Antonia-Tunsoiu/4-Stage-Amplifier/PROIECT LA DISCIPLINA SCIA.pdf

# PROIECT LA DISCIPLINA SCIA

# SEMESTRUL I

2025-2026

### Student: Tunsoiu Antonia-Emilia

### Anul III, grupa 2132, Specializarea electronică aplicată

## 1.Tematica proiectului

Să se proiecteze un circuit format din 4 etaje care să respecte următoarele specificații:

Etaj 1
Tip Sursă semnal | Amplitudine minimă | Amplitudine maximă | Unitate măsură | Tip Etaj 1 | Câștig etaj 1 (liniar)
2 | 1.40E-01 | 2.79E-01 | V (diferențial) | 4 | 5

Etaj 2
Tip Etaj 2 | Câștig în banda de trecere (liniar) | Rintrare minim | Bandă | Q
1 | 1 | 7.50E+02 | 8.00E+03 | 1.41

Etaj 3
Tip Etaj 3 | Câștig minim [db] | Rezoluție [db] | Nr. pași | Câștig maxim | Rintrare minim
1 | 8 | 2 | 4 | 14 | 1.50E+03
Etaj 4 | Tip AO
Tip etaj 4 | Câștig etaj 4 (liniar) | ADA4077
10 | 1

## 2.Implementare teoretică

## 1. ETAJ 1

### 1.1. Specificații

Etaj 1
Tip Sursă semnal | Amplitudine minimă | Amplitudine maximă | Unitate măsură | Tip Etaj 1 | Câștig etaj 1 (liniar)
2 | 1.40E-01 | 2.79E-01 | V (diferențial) | 4 | 5

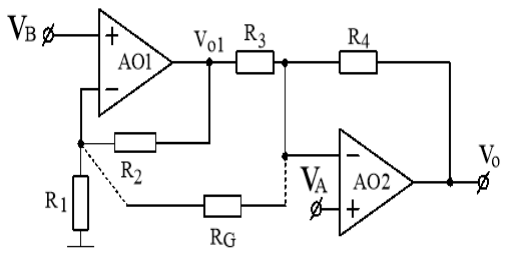
[picture p1: figure]
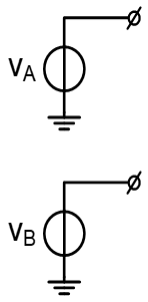
[picture p2: figure]

Fig.1. Tip 2 Sursă Semnal | Fig. 2. Tip 4 Etaj 1

Primul etaj constă într-un amplificator de instrumentație realizat într-o configurație cu două amplificatoare operaționale de precizie ADA4077. Circuitul beneficiază de o alimentare simetrică de ±5V, asigurând o procesare stabilă a semnalului de intrare diferențial, a cărui amplitudine variază între 140 mV și 279 mV, iar etajul asigură un câștig liniar de 5.

### 1.2. Dimensionarea și proiectarea Etajului 1

### 1.2.1. Proiectarea sursei de tensiune

Pentru simularea alimentării diferențiale s-au utilizat două surse de tensiune comandate în tensiune (E1 și E2). Sursa de intrare Vid stabilește amplitudinea diferențială totală, între 140 mV – 279 mV. Cele două surse comandate au factori de transfer de 0.5 și astfel generează semnale în antifază raportate la nodul comun. Sursa Vicm permite setarea tensiunii de mod comun. Este setată la 0, pentru a asigura o ieșire simetrică față de masă.

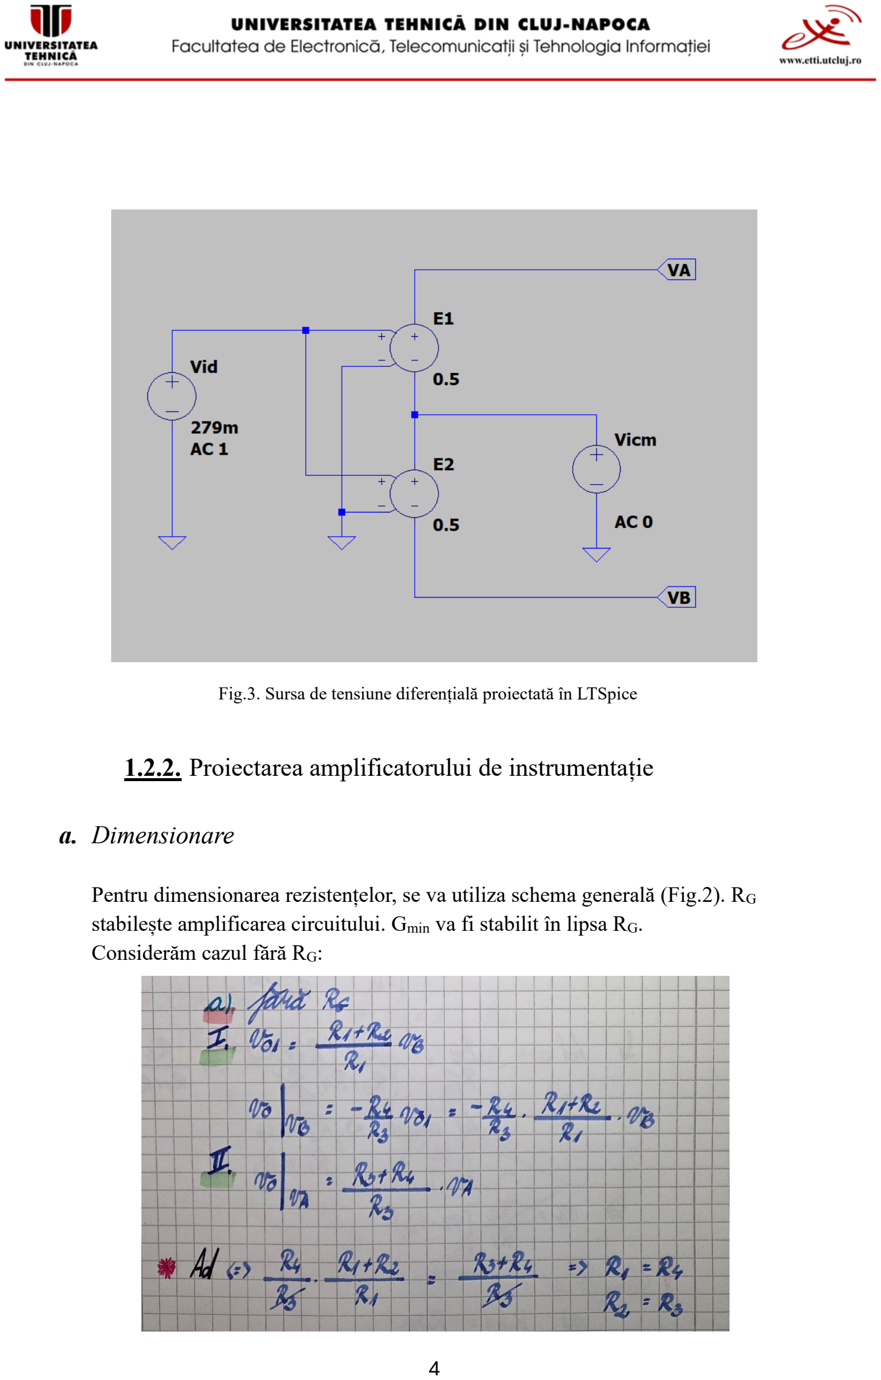
[picture p3: page 4]

Fig.3. Sursa de tensiune diferențială proiectată în LTSpice

### 1.2.2. Proiectarea amplificatorului de instrumentație

### a. Dimensionare

Pentru dimensionarea rezistențelor, se va utiliza schema generală (Fig.2). RG stabilește amplificarea circuitului. Gmin va fi stabilit în lipsa RG.
Considerăm cazul fără RG:

Pentru a respecta condițiile unui amplificator de instrumentație, se impun condițiile: R1 = R4
R2 = R3
Simplificând relația, rezultă amplificarea pentru Gmin:
Vout = (1 +

R3
R4
) (VA − VB) | unde | VA − VB= Vid

Alegem Gmin=2.5 și dimensionăm R1, R2, R3, R4.
- Rezistențele de valori mici vor permite trecerea unui curent de valori mari, ceea ce va distruge circuitul.
- Rezistențele de valori mari pot degrada marja de fază a circuitului și pot introduce zgomot suplimentar în circuit.
Alegem:
R1 = R4 = 1.5 kΩ
R2 = R3 = 1 kΩ

Aceste valori sunt suficient de mari cât să limiteze curentul, dar puterea disipată pe ele este destul de mică astfel încât rezistențele nu se vor încinge deloc

Considerăm cazul cu RG:

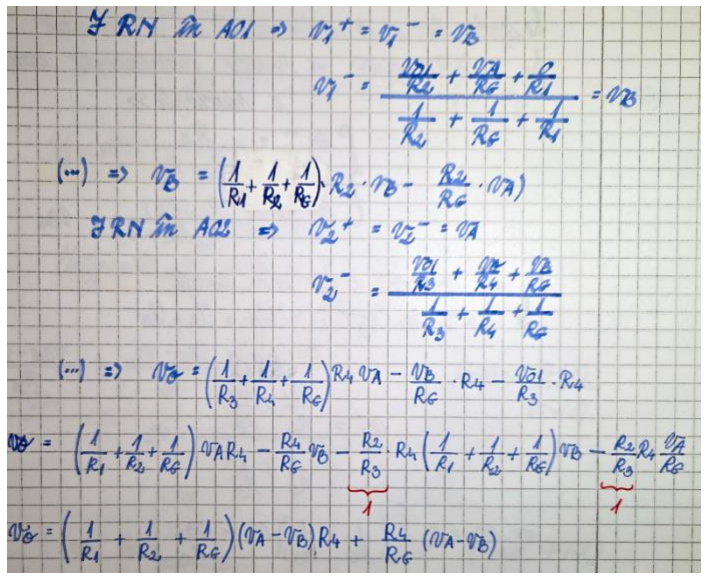
[picture p4: figure]

Din calcul, rezultă amplificarea pentru G:

Vout = (1 +

R3
R4

+

2 ∗ R4
RG

) (VA − VB)

Alegem RG=1.2k. Pentru a respecta valorile standardizate și pentru a păstra precizia, vom conecta în serie 3 rezistențe:

RG1 = 1 kΩ | ; | RG2 = RG3 = 100Ω

### b. Proiectare

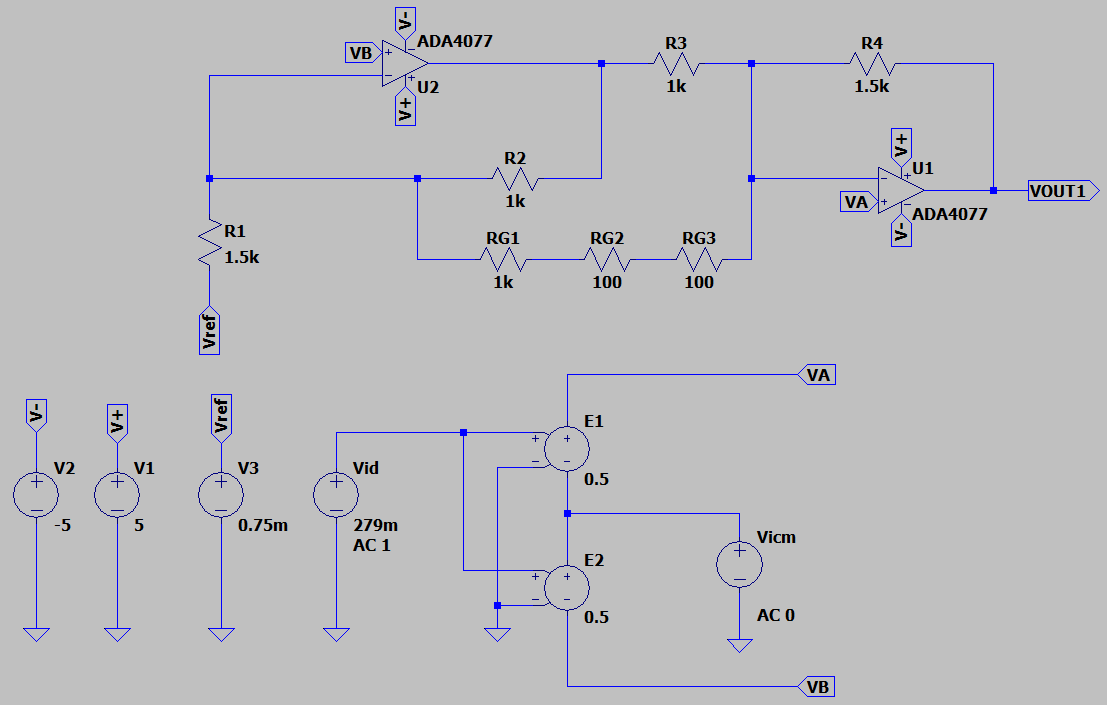
[picture p5: figure]

Fig.4. Proiectarea generatorului de semnal și a Etajului 1

### 1.3. Caracterizarea Etajului 1

a) DC OP

### - Punctul static de funcționare

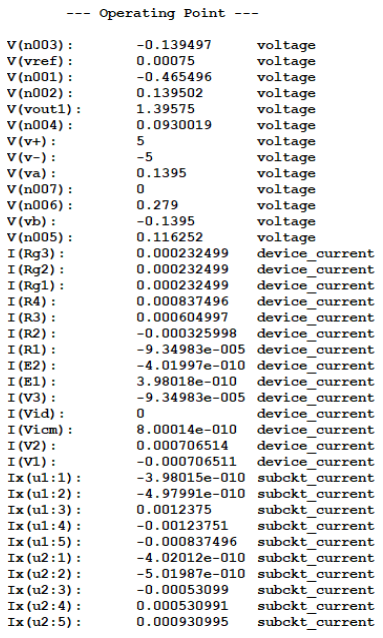
[picture p6: figure]

1. Tensiunea de Ieșire

V(vout1) = 1.39575V.
Valoarea se află în intervalul dat de tensiunea de alimentare pozitivă (+5V) și cea negativă (-5V), deci semnalul de ieșire nu va fi limitat.
2. Câștigul liniar

1.395V / 0.279V = 5.

3. Curenții de intrare

Curenții Ix(u1:1) și Ix(u2:1) sunt de ordinul picoAmperilor, ceea ce evidențiază impedanța de intrare foarte mare a etajului.

Fig.5. Analiza .op pentru amplitduinea maxima de intrare

1. Tensiunea de Ieșire

V(vout1) = 0.700748V.
Valoarea se află în intervalul dat de tensiunea de alimentare pozitivă (+5V) și cea negativă (-5V), deci semnalul de ieșire nu va fi limitat.
2. Câștigul liniar

0.700V / 0.140V = 5.

3. Curenții de intrare

Curenții Ix(u1:1) și Ix(u2:1) sunt de ordinul picoAmperilor, ceea ce evidențiază impedanța de intrare foarte mare a etajului.

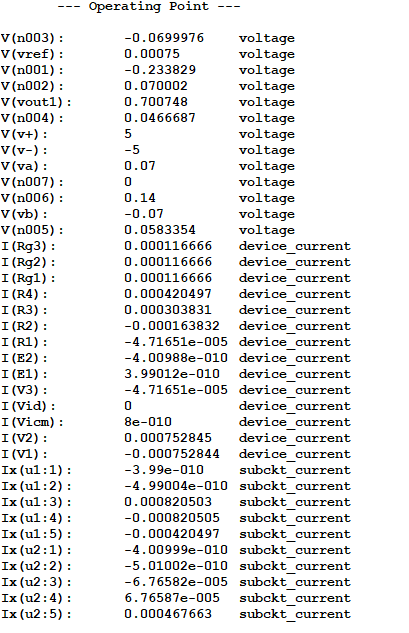
[picture p7: figure]

Fig.6. Analiza .op pentru amplitduinea minima de intrare

### - Compensarea nivelului DC la ieșire

S-a realizat cu ajutorul unei surse de tensiune constantă, aplicată la capătul rezistenței R1. Pentru a stabili valoarea sursei, sursa de semnal de intrare a fost setată la 0V și s-a analizat deplasarea axei în raport cu 0, prin analiza .op.

Pentru a respecta amplificarea de 5 atât pentru amplitudinea minimă, cât și cea maximă, s-a ales ca tensiunea de referință să aibă valoarea de 0.75 mV:

Amplitudine semnal
intrare

Tensiune de ieșire
FĂRĂ Vref

Tensiune de ieșire
CU Vref

Tensiune de ieșire
ideală
140 mV | 699.99796 mV | 700.74797 mV | 700 mV
279 mV | 1.3949959 V | 1.3957459 V | 1.395V

b) AC
Pentru analiza în frecvență, am setat o simulare AC cu următorii parametri:

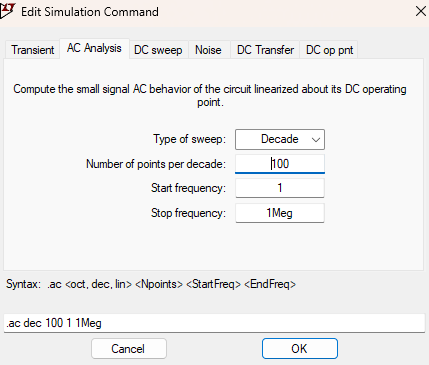
[picture p8: figure]

Fig.7. Setarea analizei AC

### - Câștig la joasă frecvență

Matematic, câștigul la joasă frecvență este dat de formula 20 lg(|G|). Astfel, câștigul la joasă frecvență pentru circuitul dat este: 13.97 dB. Acest rezultat este verificat și de graficul tensiunii de ieșire:

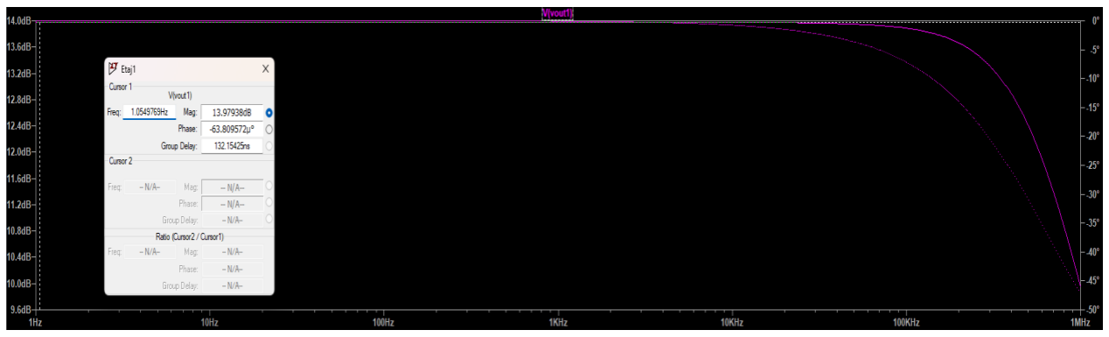
[picture p9: figure]

Fig.8. Verificarea câștigului la joasă frecvență

### - Banda etajului > Banda filtrului (etaj 2)

În specificațiile proiectului, banda filtrului din etajul 2 este de 8 kHz. Banda etajului 1 este dată de valoarea frecvenței la -3dB, raportat la câștigul la joasă frecvență. Așadar, trebuie să determinăm frecvența la 10.97 dB:

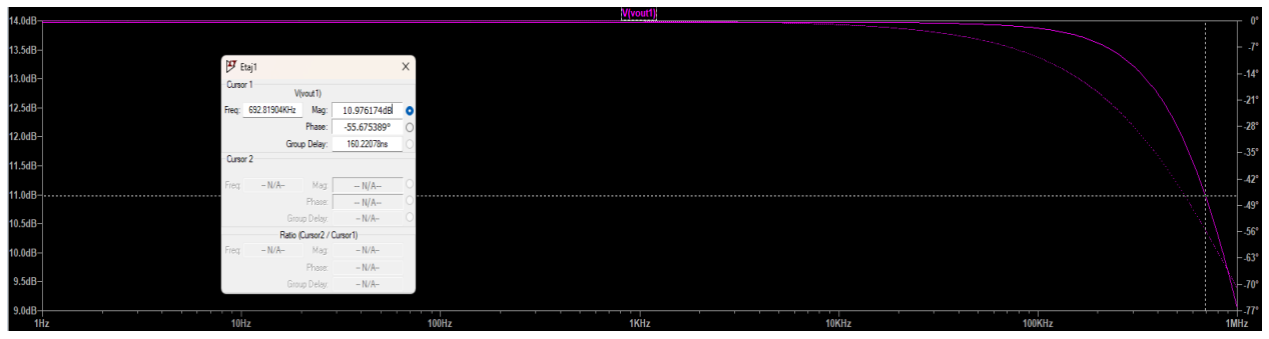
[picture p10: figure]

Fig.8. Determinarea benzii

Din această simulare se observă că frecvența de tăiere este 692.81904kHz.

692.81904kHz > 8 kHz, deci primul etaj nu va introduce atenuări sau defazaje ce ar putea influența performanța celui de-al doilea etaj.

Conform fișei tehnice, ADA4077 are un GBW de 3.9 MHz. Frecvența maximă a circuitului se calculează cu formula: fmax =

GBW
G

=

3.9 MHz
5

= 780 kHz.

692.8 kHz < 780 kHz, deci circuitul se încadrează în limitele fizice ale componentei, oferind în același timp o bandă suficientă pentru a nu influența etajele următoare.

### - CMRR

CMRR reprezintă capacitatea unui amplificator de a respinge semnalele nedorite. Este raportul dintre câștigul în mod diferențial (Ad) și câștigul în mod comun (Acm).

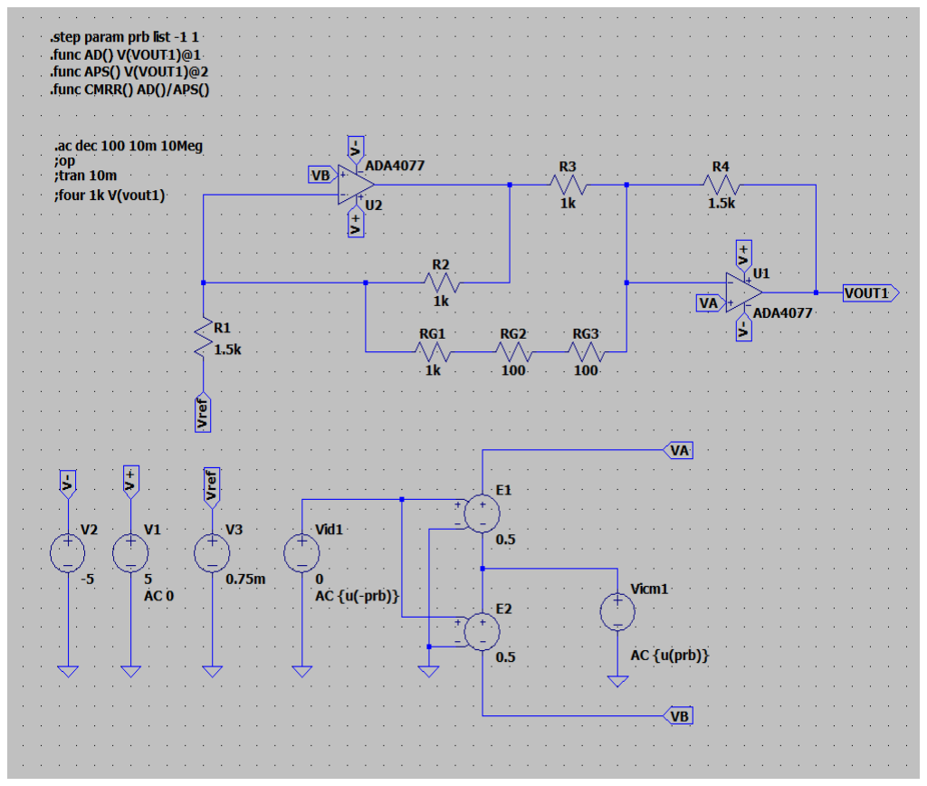
[picture p11: figure]

Pentru a vizualiza
graficul CMRR s-a utilizat analiza parametrică. Inițial, intrarea Vid1 a fost activată,
permițând | măsurarea
câștigului diferențial.

În etapa a doua,
semnalul de mod comun a
fost injectat simultan pe
ambele intrări ale etajului, facilitând determinarea
câștigului de mod comun.

Fig.9. Definirea analizei
parametrice pentru CMRR

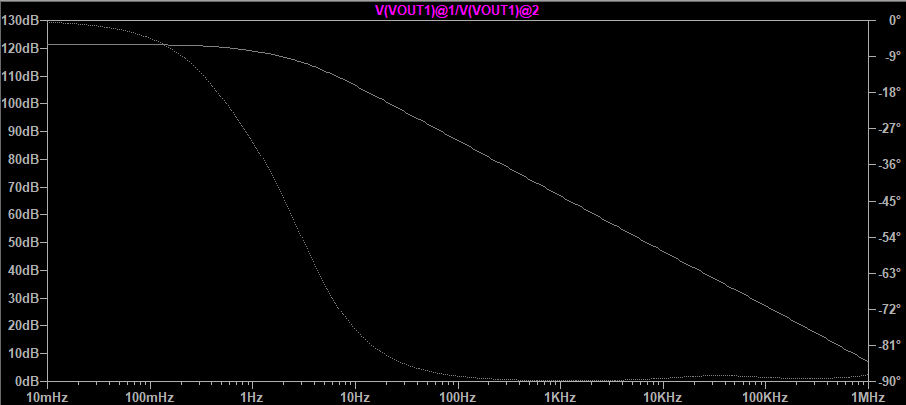
[picture p12: figure]

Fig.10. Graficul raportului CMRR

Fișa de catalog a ADA4077 indică o valoare a CMRR între 122dB – 140dB. În simularea realizată, valoarea CMRR atinge pragul de 122dB în punctul său maxim. Astfel, rezultatele demonstrează precizia deosebită a amplificatorului în eliminarea erorii cauzate de tensiunea de mod comun. Deși rejecția scade odată cu creșterea frecvenței, amplificatorul menține o valoare ridicată, garantând astfel integritatea semnalului.

### - PSRR

PSRR reprezintă capacitatea unui circuit electronic de a menține neschimbată tensiunea de ieșire atunci când apar perturbații. Este raportul dintre câștigul în mod diferențial (Ad) și câștigul parazit al alimentării (Aps).

Pentru | a | vizualiza
graficul PSRR s-a utilizat analiza parametrică. Inițial, intrarea Vid1 a fost activată,
permițând | măsurarea
câștigului diferențial.

În etapa a doua, un
semnal perturbator de tip AC a fost injectat simultan pe ambele ramuri de alimentare.
Această | configurație | a
facilitat | determinarea
câștigului parazit indus de variațiile alimentării.

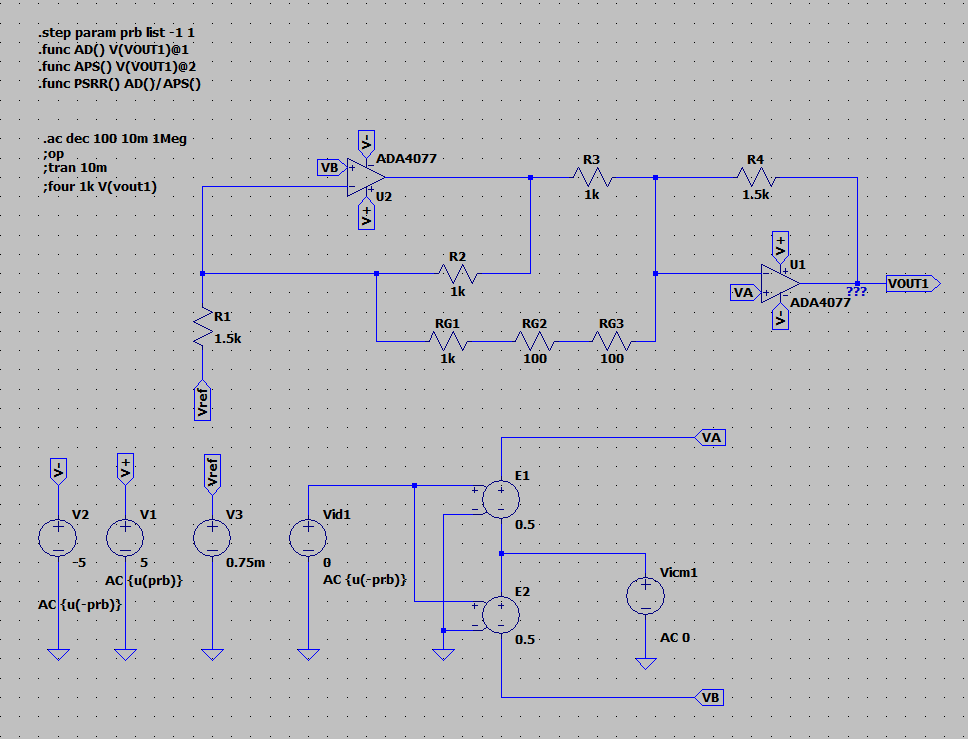
[picture p13: figure]

Fig.11. Definirea analizei parametrice pentru PSRR

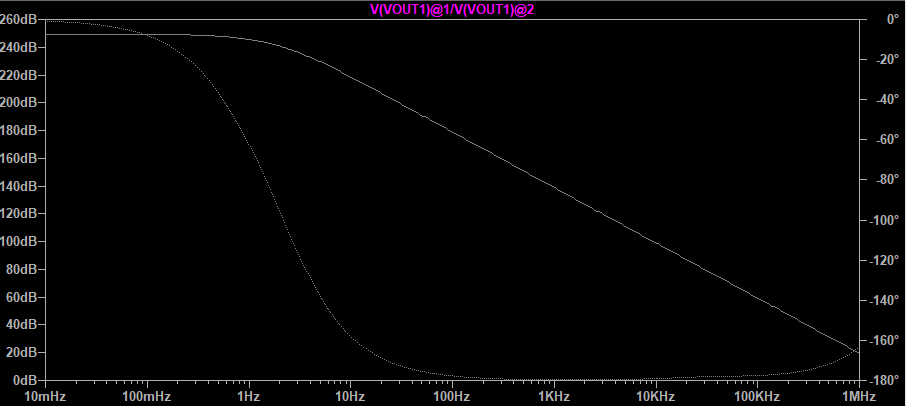
[picture p14: figure]

Fig.10. Graficul raportului PSRR

Fișa de catalog a ADA4077 specifică o valoare a PSRR între 123 dB – 128 dB. În simularea realizată, valoarea PSRR depășește pragul de 120dB, atingând un maxim ideal de aproximativ 250dB la frecvențe sub 1Hz. Astfel, rezultatele demonstrează precizia deosebită a amplificatorului în eliminarea erorilor cauzate de variațiile tensiunii de alimentare. Deși rejecția scade odată cu creșterea frecvenței, amplificatorul menține o valoare ridicată a acesteia, garantând astfel integritatea semnalului și stabilitatea punctului de funcționare. Această performanță superioară asigură menținerea distorsiunilor sub pragul de 1%, eliminând riscul ca zgomotul de alimentare să moduleze semnalul util de ieșire.

c) TRANSIENT

### - Slew Rate

Slew Rate-ul reprezintă viteza maximă cu care tensiunea de ieșire a unui amplificator poate varia în timp. Pentru determinarea Slew Rate-ului, s-a aplicat la intrare un semnal de tip impuls cu amplitudine mare, pentru a scoate amplificatorul din regimul liniar de semnal mic.

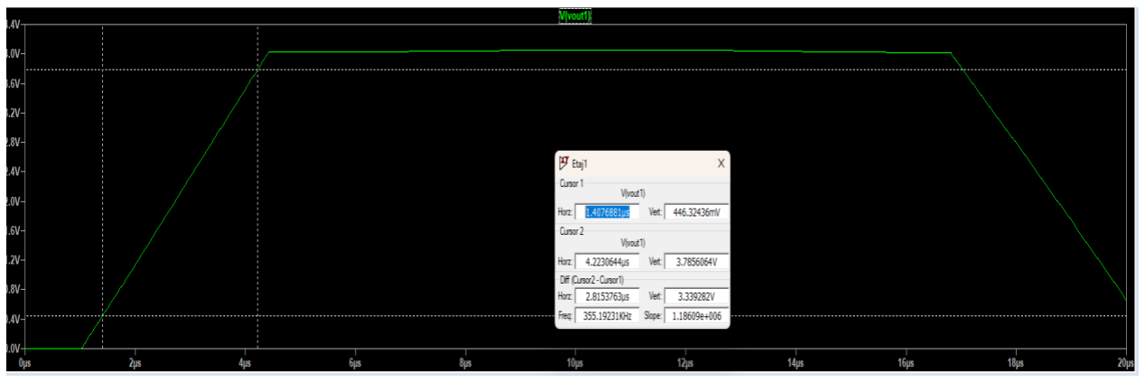
[picture p15: figure]

Fig.9. Determinarea SR

Conform graficului din Fig.9. și a formulei de calcul, SR circuitului este:

SR =

ΔVOUT
Δt

= 1.186 V/us

Conform fișei tehnice, ADA4077 are un Slew Rate de 1.2 V/µs. Acest lucru confirmă că primul etaj poate urmări rapid semnalele de intrare fără a introduce distorsiuni de pantă în banda de lucru.

Se calculează SR pentru semnalul rezultat în Fig.9: SR = 2πfVOUT = 0.201 V/us. Așadar, SR rezultat din măsurătorile din LTSpice este cu mult mai mare decât SR necesar, conform calculelor.

### - Total Harmonic Distortion

Total Harmonic Distortion (THD) este un parametru ce evaluează fidelitatea unui circuit prin măsurarea gradului de "poluare" a semnalului original cu componente spectrale nedorite (armonici). Ideal, acesta este 0, așadar în practică se dorește a fi cât mai mic ( THD < 1%).

Pentru a verifica performanța etajului în cel mai defavorabil scenariu, s-a aplicat la intrare un semnal sinusoidal cu amplitudinea maximă de 279 mV. În LTSpice, vom vizualiza o analiză de tip FFT:

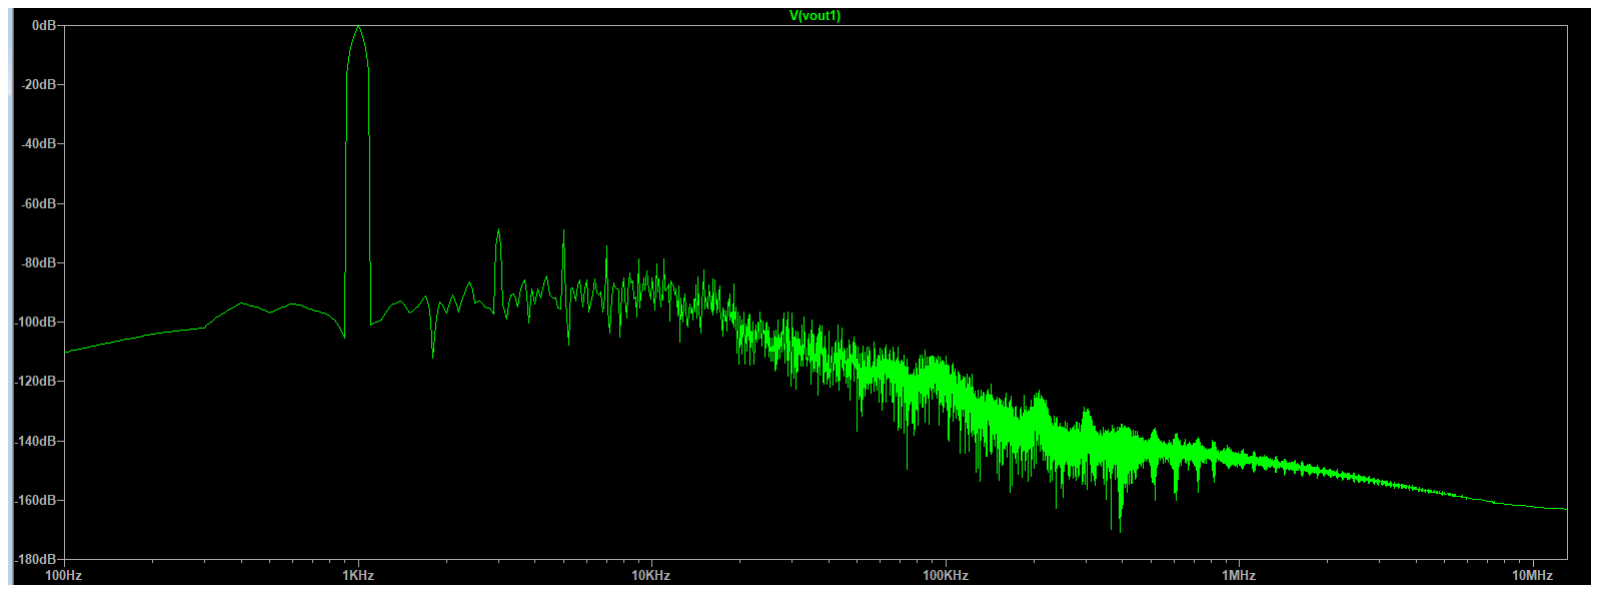
[picture p16: figure]

Fig.10. Analiza FFT

În grafic se observă un vârf proeminent la frecvența fundamentală (armonica 1), situat la aproximativ 0 dB. Armonicile de ordin superior au magnitudinea extrem de redusă, situându-se sub pragul de -70 dB față de fundamentală. Acest raport semnal-distorsiune foarte mare demonstrează că amplificatorul ADA4077 funcționează într-un regim de înaltă liniaritate.

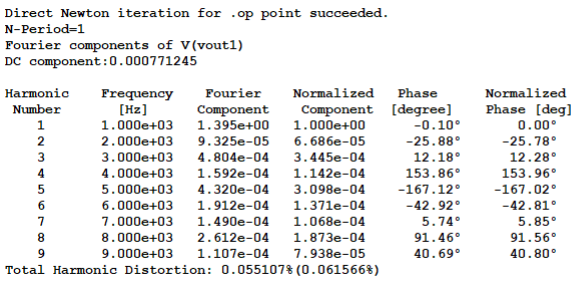
[picture p17: figure]

. | Fig.11. Error Log FFT

Observând rezultatele numerice din Error Log, pentru amplitudinea maximă, THD pentru worst case este 0.055% < 1%. Nivelul redus al distorsiunilor este susținut de rapoartele de rejecție ridicate, care împiedică zgomotul de mod comun sau cel de alimentare să moduleze semnalul util și să introducă componente armonice parazite.

## 2. ETAJ 2

### 2.1. Specificații

Etaj 2
tip Etaj 2 | |H0| câștig liniar în banda de trecere | R intrare minim | Banda | Q
1 | 1 | 7.50E+02 | 8.00E+03 | 1.41

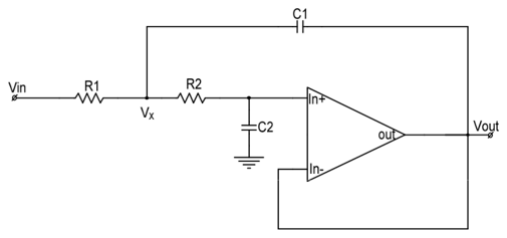
[picture p18: figure]

Fig.12. Tip 1 Etaj 2 – Filtru Low Pass Sallen Key

Al doilea etaj constă într-un filtru trece-jos realizat în configurație Sallen-Key de ordinul 2. Circuitul este un repetor, astfel că avem un câștig liniar unitar, asigurând integritatea amplitudinii semnalului în banda de trecere. Etajul este calibrat pentru o frecvență de tăiere de 8 kHz și un factor de calitate Q = 1.41, valoare specifică pentru o atenuare maximă în banda de trecere. Circuitul impune o rezistență de intrare minimă de 750Ω.

### 2.2. Dimensionarea și proiectarea Etajului 2

### 2.2.1. Proiectarea filtrului trece-jos

### a. Dimensionare

Pentru dimensionare se utilizează schema generală (Fig.12). Ca strategie de dimensionare, se obișnuiește să se aleagă R1 = R2:

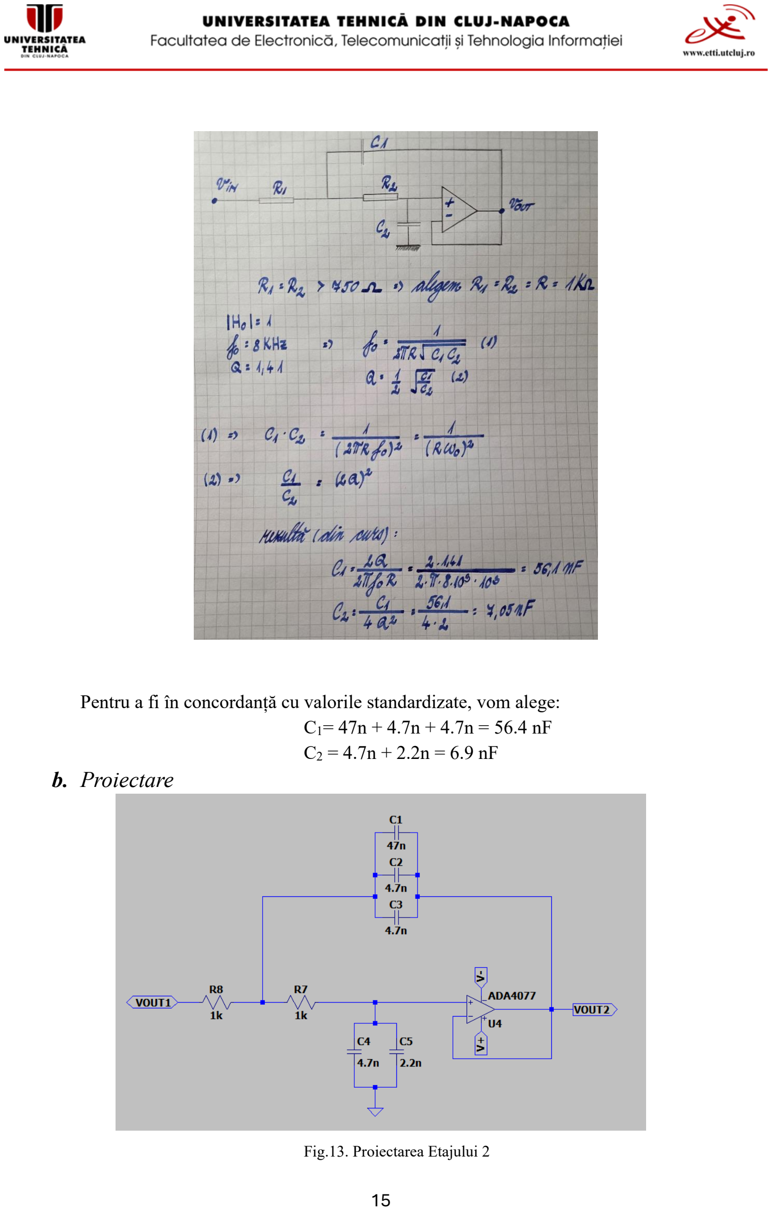
[picture p19: page 15]

Pentru a fi în concordanță cu valorile standardizate, vom alege: C1= 47n + 4.7n + 4.7n = 56.4 nF C2 = 4.7n + 2.2n = 6.9 nF

### b. Proiectare

Fig.13. Proiectarea Etajului 2

### 2.3. Caracterizarea Etajului 2

a) DC OP

### - Punctul static de funcționare

Pentru a demonstra că filtrul Sallen-Key realizat nu introduce niciun fel de eroare, am realizat o analiză de tip .op, cu tensiunea de intrare 0:

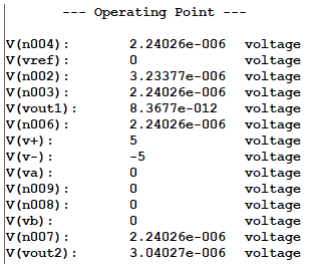
[picture p20: figure]

Fig.14. Analiza .op pentru tensiunea de intrare 0

Se observă că V(Vou2) este aproximativ 3uV, o valoare infimă care se poate neglija.

b) AC
Pentru analiza în frecvență, am păstrat parametrii analizei AC folosite în cadrul simulării etajului 1.

### - Câștigul în banda de trecere

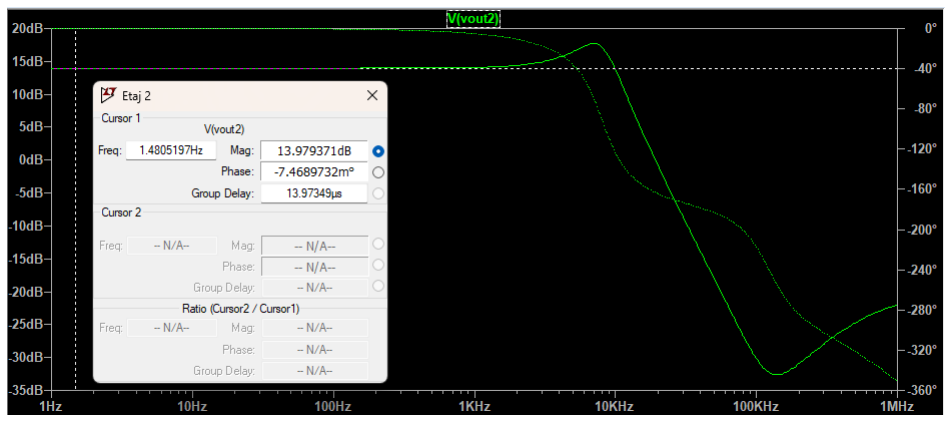
[picture p21: figure]

Fig.15. Câștigul în banda de trecere a filtrului

Fiind un filtru trece-jos în configurație de repetor, câștigul în decibeli, la ieșirea etajului, coincide cu câștigul de la intrarea acestuia (Fig.8). Peak-ul observat în jurul frecvenței de 8 kHz se datorează factorului de calitate, Q = 1.41 >0.707 => se observă o supracreștere în caracteristica de magnitudine ce favorizează o trecere mai bruscă de la banda de trecere la banda de tăiere în detrimentul liniarității.

### - Banda filtrului

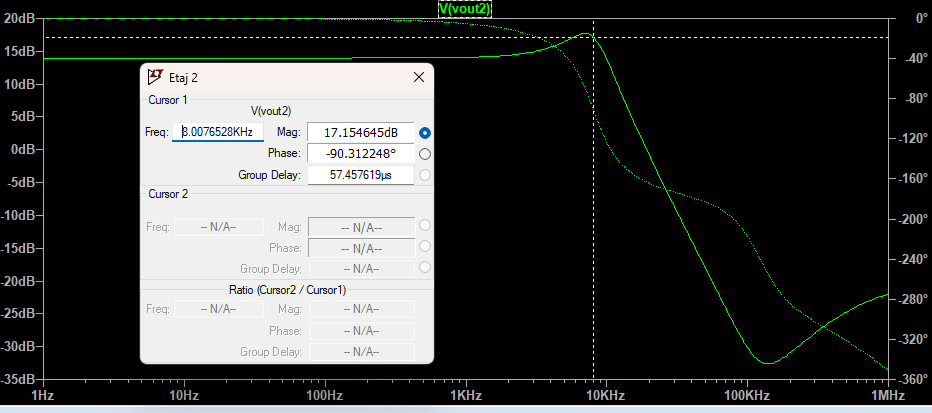
[picture p22: figure]

Fig.16. Calculul benzii filtrului

Un pol introduce un defazaj de -90 grade. Așa cum reiese din grafic, banda filtrului este de 8 kHz.

c) Transient

Pentru analiza de tip Transient, trebuie verificat faptul că nu există distorsiuni la frecvența fin/10. Amplitudinea de 279 mV ar trebui să genereze o tensiune de 1.395V la ieșire, valoare verificată în simulări prin graficul dat mai jos:

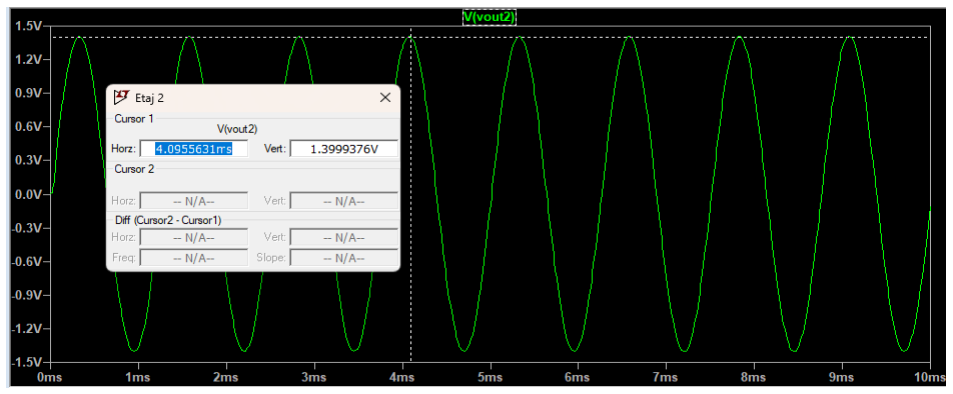
[picture p23: figure]

Fig.17. Analiza Transient pentru amplitudinea de intrare maximă

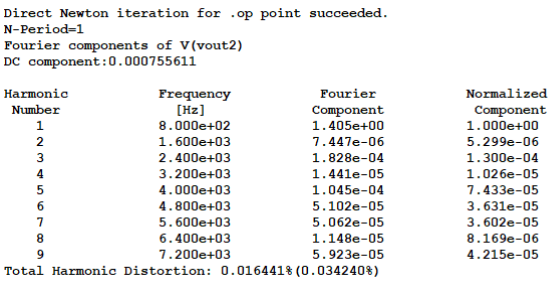
[picture p24: figure]

Fig.18. Valoarea THD la ieșirea etajului 2

La frecvența de 800 Hz, THD-ul total va fi 0.0164%, deci Etajul 2 funcționează optim ca repetor de tensiune în banda de trecere.

## 3. ETAJ 3

### 3.1. Specificații

Etaj 3

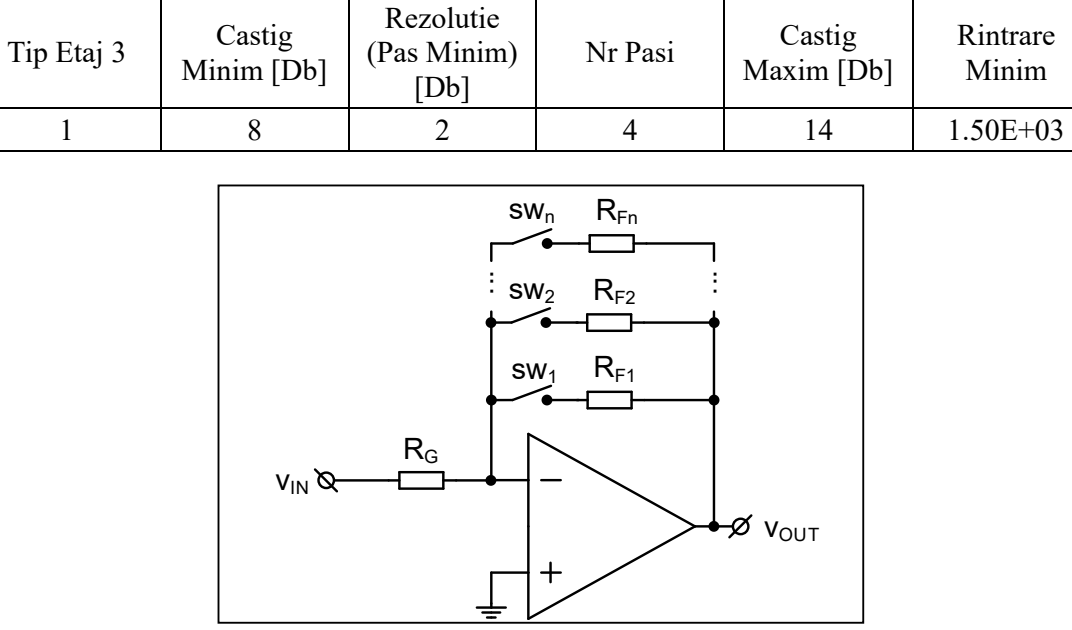
[picture p25: figure]
Tip Etaj 3; Castig Minim [Db]; Rezolutie (Pas Minim) [Db]; Nr Pasi; Castig Maxim [Db]; Rintrare Minim; vOUT; vIN; swn; RFn

Fig.19. Tip 1 Etaj 3

Etajul 3 este un amplificator inversor cu câștig programabil, configurat pentru a oferi un control al amplitudinii în 4 pași. Acesta asigură un câștig minim de 8 dB și un câștig maxim de 14 dB, având o rezoluție de 2 dB. Circuitul este proiectat cu o impedanță de intrare de minim 1.50 kΩ, utilizând o rețea de reacție cu switch-uri în calea de semnal.

### 3.2. Dimensionarea și proiectarea Etajului 3

### 3.2.1. Proiectarea amplificatorului de instrumentație

### a. Dimensionare

Pentru dimensionarea rezistențelor, se va utiliza schema generală (Fig.19).

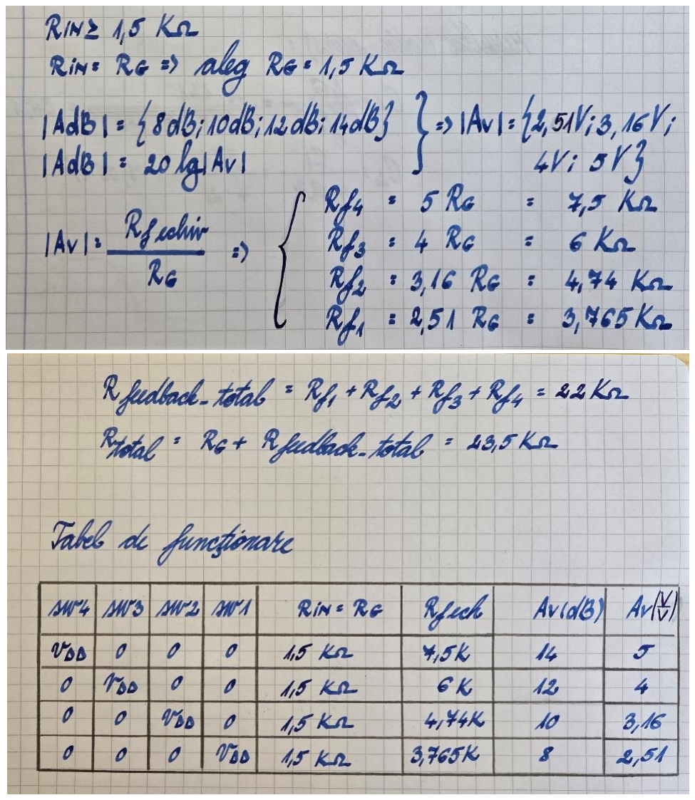
[picture p26: figure]

Fig.19 și 20. Proiectarea etajului 3 și tabelul de funcționare al PGA-ului

### b. Proiectare

Deoarece câștigul minim PGA pentru amplitudine maximă/ câștigul maxim PGA pentru amplitudine minimă va fi de 3.5 V, se va alege ca sursă de alimentare pentru etajul 3 valoarea de 10V (pentru a nu satura amplificatorul). Considerând calculele teoretice, s-au ales următoarele valori ale rezistențelor, în conformitate cu valorile standardizate:

Rezistența | Valoare calculată (Ω) | Valoare aleasă (Ω)
RG | 1.5 K | 1.5 K
Rf1 | 3.765 K | 3.770 K
Rf2 | 4.74 K | 4.474 K
Rf3 | 6 K | 6 K
Rf4 | 7.5 K | 7.5 K

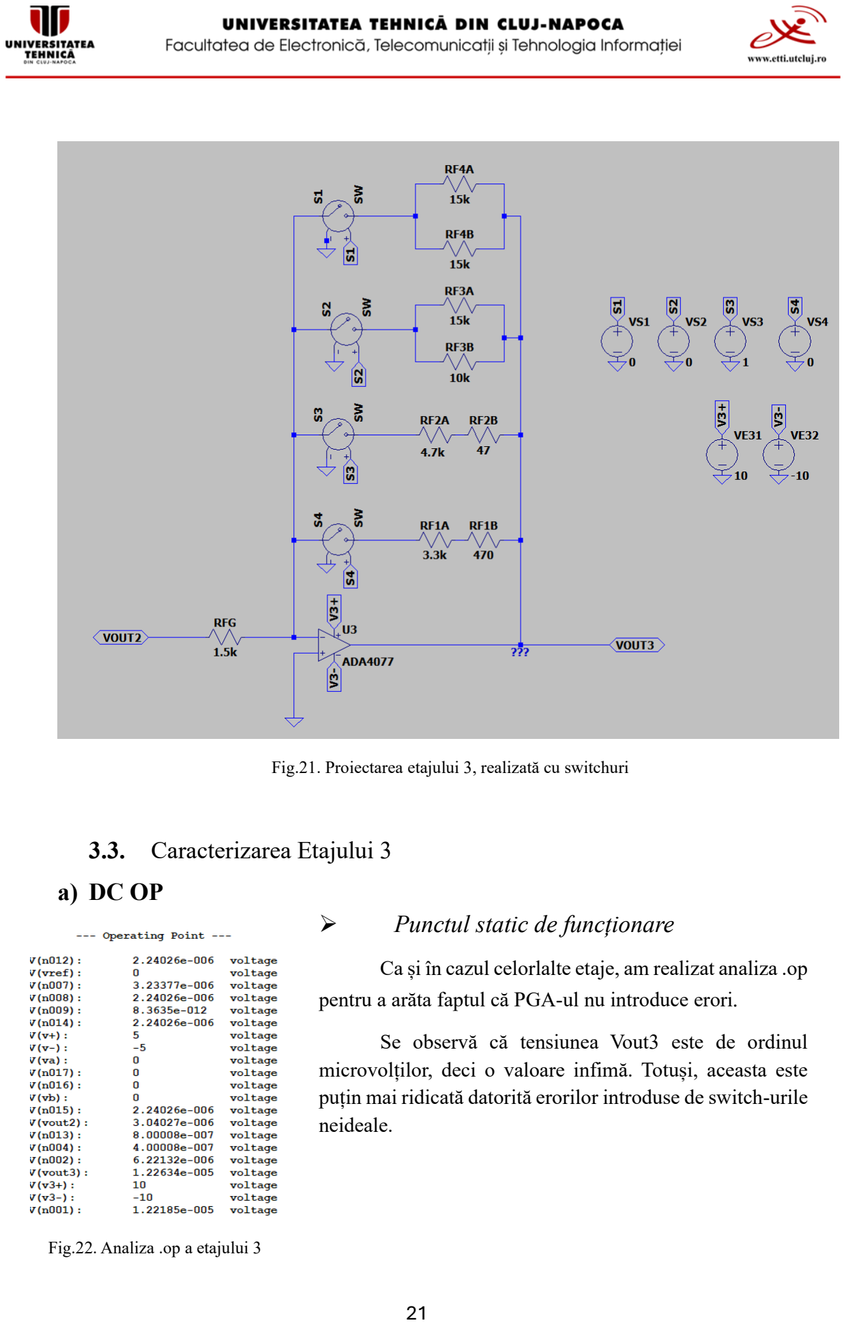
[picture p27: page 21]

Fig.21. Proiectarea etajului 3, realizată cu switchuri

### 3.3. Caracterizarea Etajului 3

a) DC OP

### - Punctul static de funcționare

Ca și în cazul celorlalte etaje, am realizat analiza .op pentru a arăta faptul că PGA-ul nu introduce erori.

Se observă că tensiunea Vout3 este de ordinul microvolților, deci o valoare infimă. Totuși, aceasta este puțin mai ridicată datorită erorilor introduse de switch-urile neideale.

Fig.22. Analiza .op a etajului 3

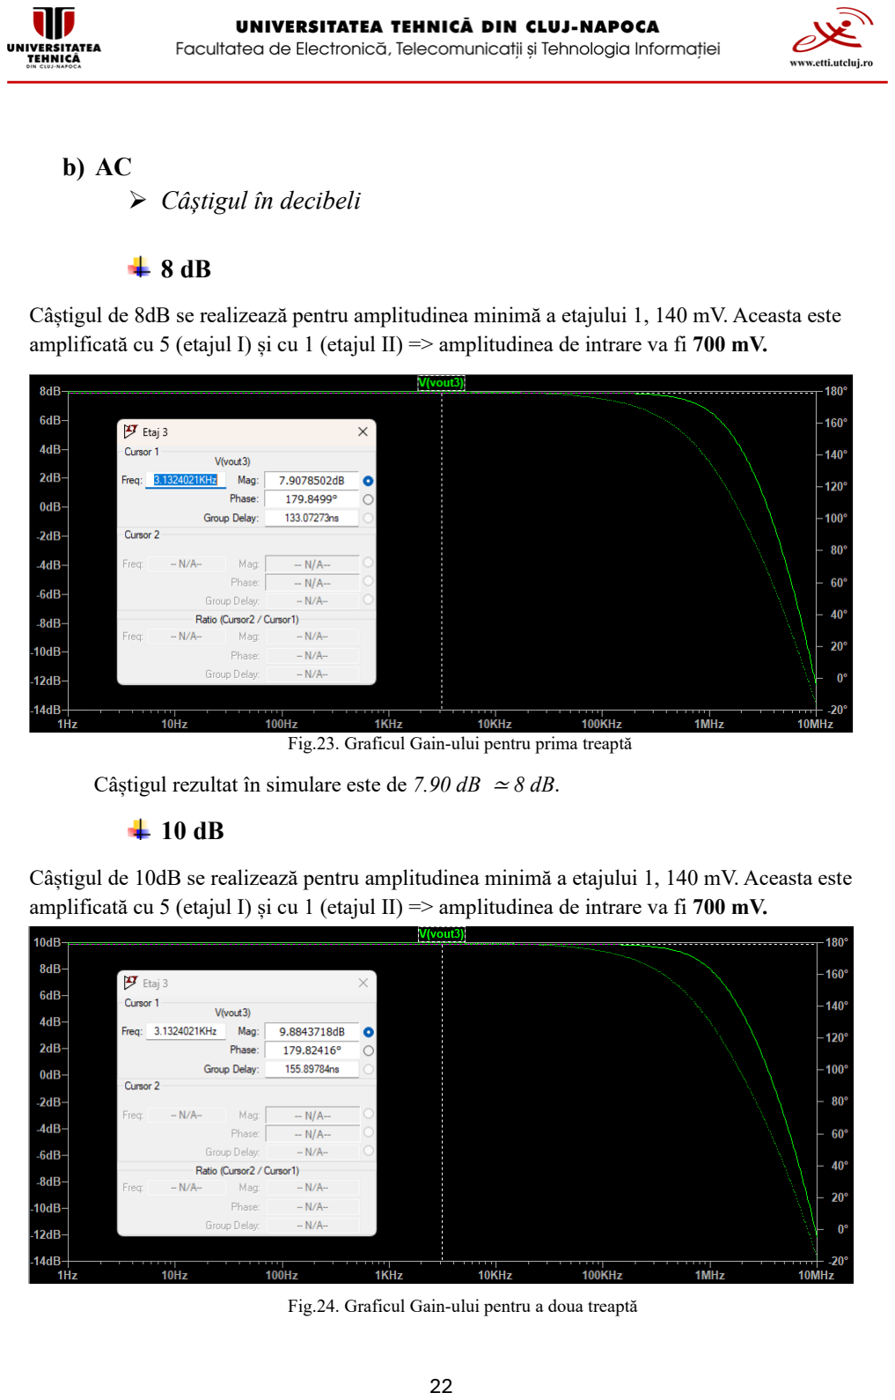
[picture p28: page 22]

b) AC

### - Câștigul în decibeli

### 8 dB

Câștigul de 8dB se realizează pentru amplitudinea minimă a etajului 1, 140 mV. Aceasta este amplificată cu 5 (etajul I) și cu 1 (etajul II) => amplitudinea de intrare va fi 700 mV.

Fig.23. Graficul Gain-ului pentru prima treaptă

Câștigul rezultat în simulare este de 7.90 dB ≃ 8 dB.

### 10 dB

Câștigul de 10dB se realizează pentru amplitudinea minimă a etajului 1, 140 mV. Aceasta este amplificată cu 5 (etajul I) și cu 1 (etajul II) => amplitudinea de intrare va fi 700 mV.

Fig.24. Graficul Gain-ului pentru a doua treaptă

Câștigul rezultat în simulare este de 9.88 dB ≃ 10 dB.

### 12 dB

Câștigul de 12dB se realizează pentru amplitudinea maximă a etajului 1, 279 mV. Aceasta este amplificată cu 5 (etajul I) și cu 1 (etajul II) => amplitudinea de intrare va fi 1.395V.

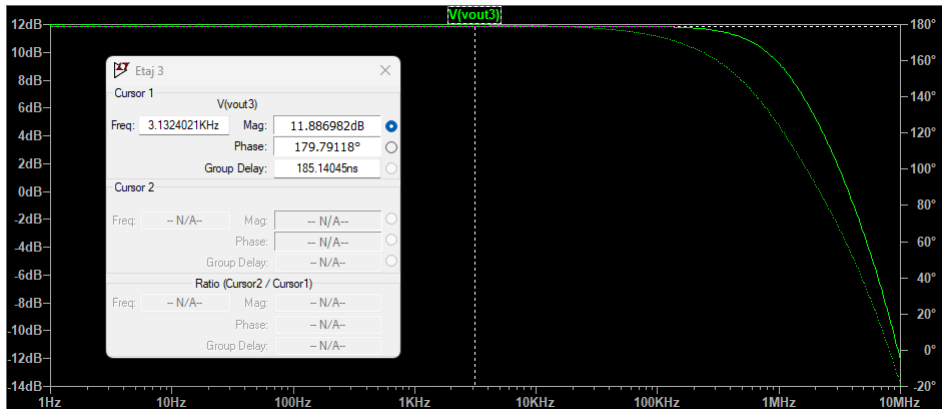
[picture p29: figure]

Fig.25. Graficul Gain-ului pentru a treia treaptă

Câștigul rezultat în simulare este de 11.88 dB ≃ 12 dB.

### 14 dB

Câștigul de 14dB se realizează pentru amplitudinea maximă a etajului 1, 279 mV. Aceasta este amplificată cu 5 (etajul I) și cu 1 (etajul II) => amplitudinea de intrare va fi 1.395V.

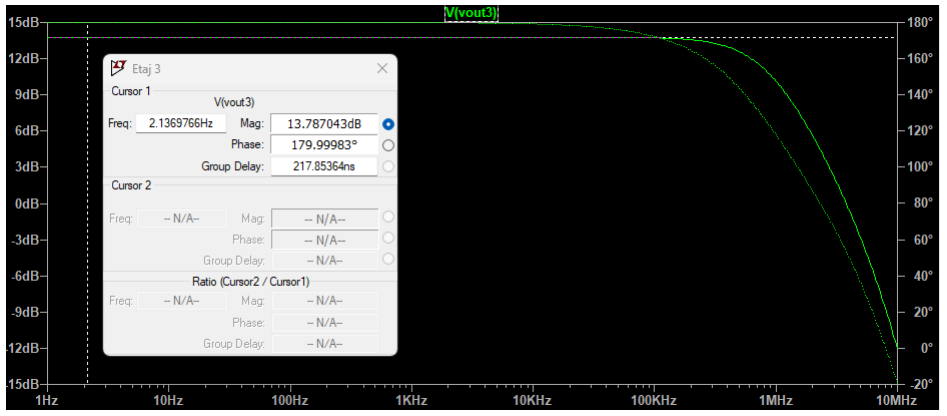
[picture p30: figure]

Fig.26. Graficul Gain-ului pentru a patra treaptă

Câștigul rezultat în simulare este de 13.78 dB ≃ 14 dB.

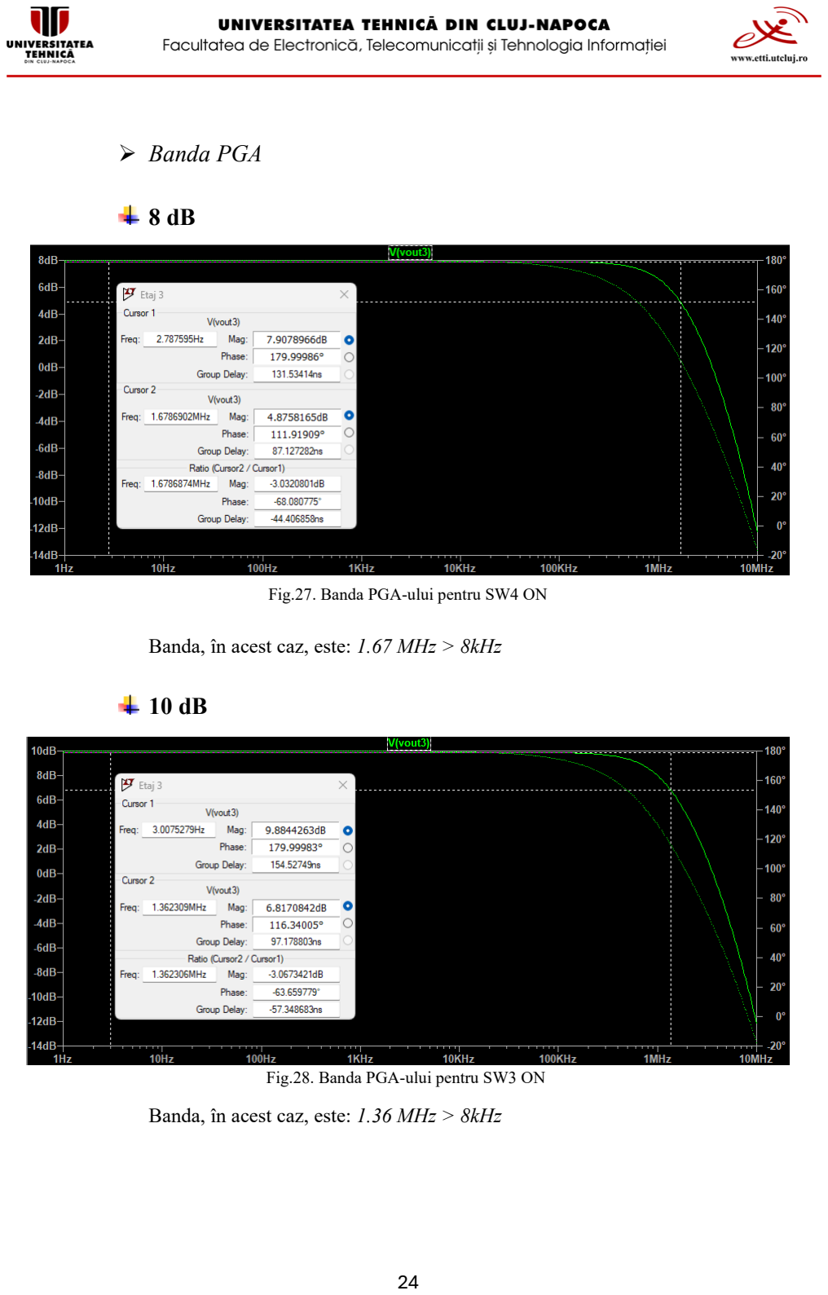
[picture p31: page 24]

### - Banda PGA

### 8 dB

Fig.27. Banda PGA-ului pentru SW4 ON

Banda, în acest caz, este: 1.67 MHz > 8kHz

### 10 dB

Fig.28. Banda PGA-ului pentru SW3 ON

Banda, în acest caz, este: 1.36 MHz > 8kHz

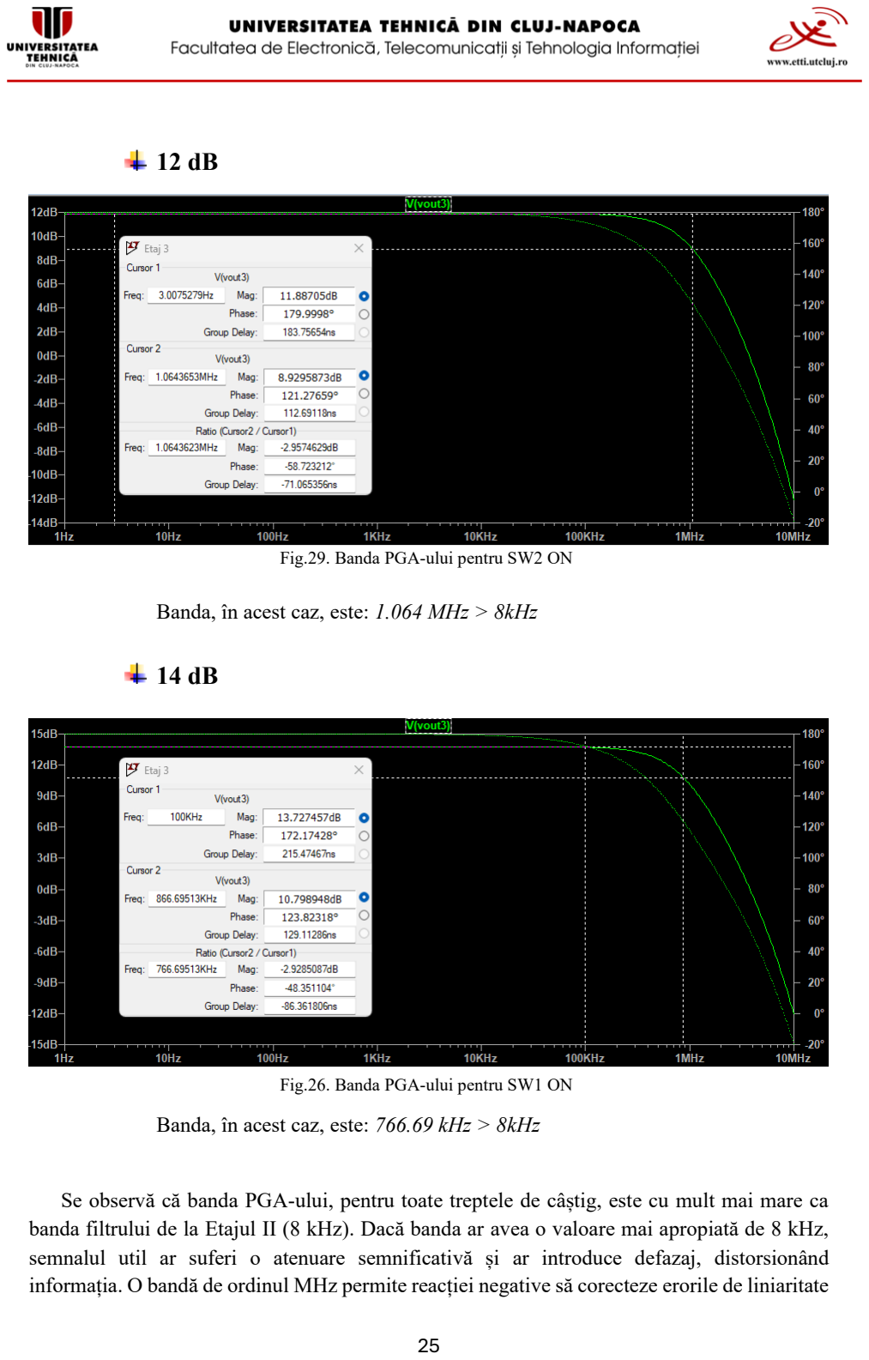
[picture p32: page 25]

### 12 dB

Fig.29. Banda PGA-ului pentru SW2 ON

Banda, în acest caz, este: 1.064 MHz > 8kHz

### 14 dB

Fig.26. Banda PGA-ului pentru SW1 ON

Banda, în acest caz, este: 766.69 kHz > 8kHz

Se observă că banda PGA-ului, pentru toate treptele de câștig, este cu mult mai mare ca banda filtrului de la Etajul II (8 kHz). Dacă banda ar avea o valoare mai apropiată de 8 kHz, semnalul util ar suferi o atenuare semnificativă și ar introduce defazaj, distorsionând informația. O bandă de ordinul MHz permite reacției negative să corecteze erorile de liniaritate și să mențină faza constantă, asigurând astfel că amplificatorul nu devine el însuși un factor limitator pentru precizia filtrului.

c) Transient

### - Liniaritate

Amplitudine minimă, pas maxim
Amplitudinea minimă la intrarea Etajului III este de 700 mV. Câștigul maxim este de 14 dB ( câștig liniar de 5). Amplitudinea semnalului de ieșire va fi: 700mV × 5 = 3.5V

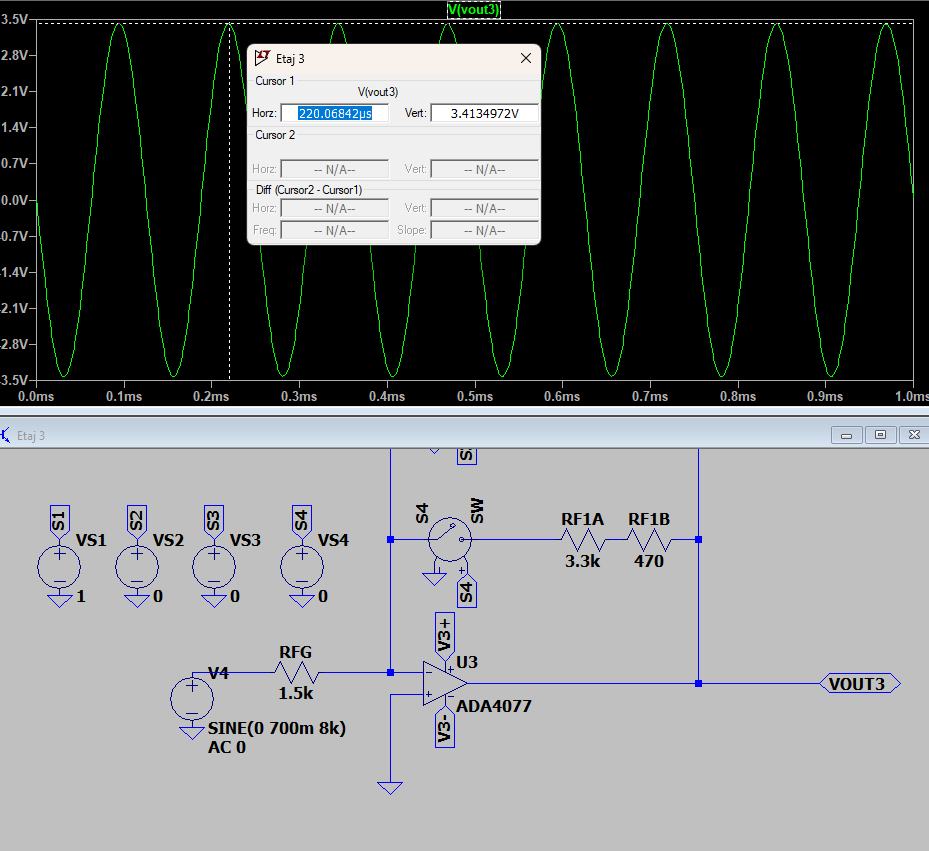
[picture p33: figure]

Fig.26. Analiza Transient pentru amplitudine minimă, câștig maxim

Aplicând transformata Fourier, se poate observa că în acest caz, coeficientul THD este 0.044% < 1%.
Astfel, se demonstrează liniaritatea oferită de ADA4077, precum și fidelitatea semnalului de ieșire.

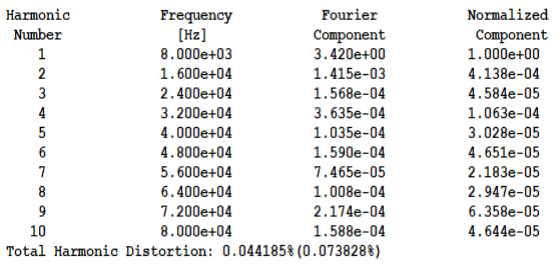
[picture p34: figure]

Fig.27. Coeficientul THD pentru Amin și Pasmax

Amplitudine maximă, pas minim
Amplitudinea maximă la intrarea Etajului III este de 1.395V. Câștigul minim este de 8 dB ( câștig liniar de 2.51).
Amplitudinea semnalului de ieșire va fi: 1.395V × 2.51 = 3.5V

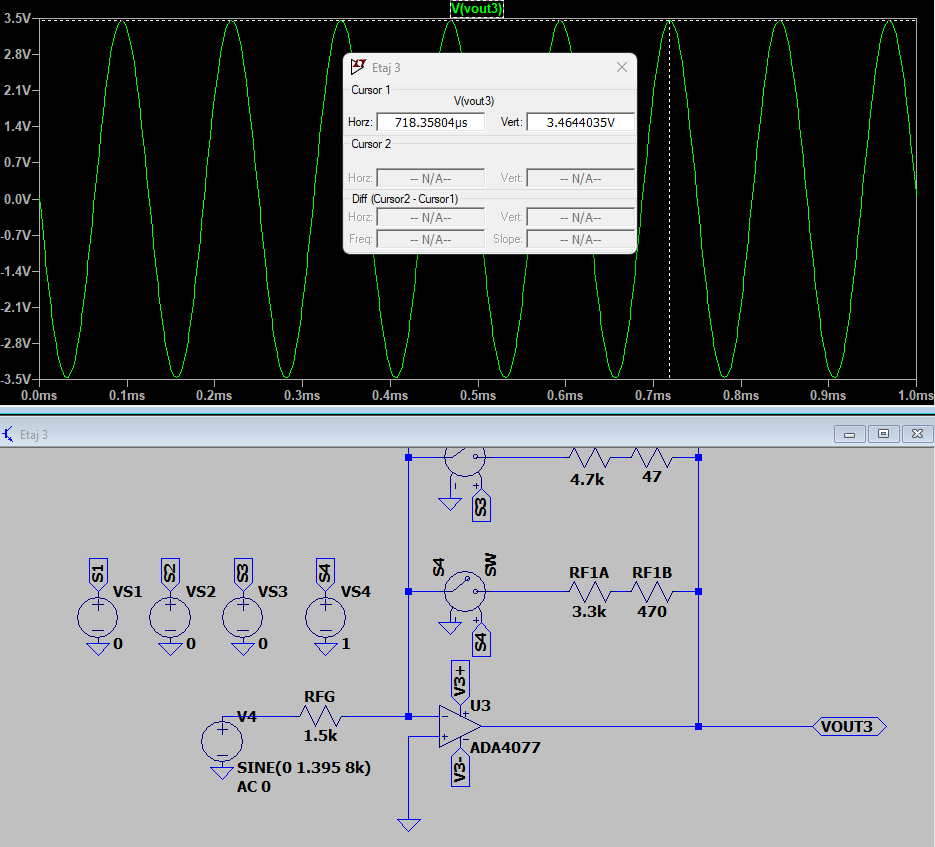
[picture p35: figure]

Fig.28. Analiza Transient pentru amplitudine maximă, câștig minim

Aplicând transformata Fourier, se poate observa că în acest caz, coeficientul THD este 0.033% < 1%.
Astfel, se demonstrează liniaritatea oferită de ADA4077, precum și fidelitatea semnalului de ieșire.

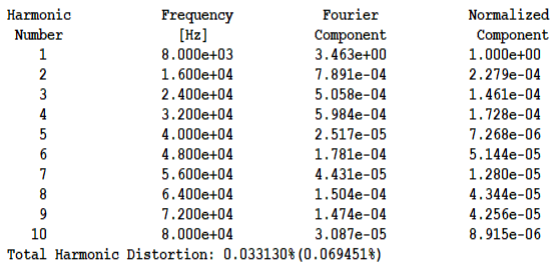
[picture p36: figure]

Fig.29. Coeficientul THD pentru Amax și Pasmin

## 4. ETAJ 4

### 4.1. Specificații

Etaj 4
Tip Etaj 4 | |Câștig| Etaj 4 (liniar)
10 | 1

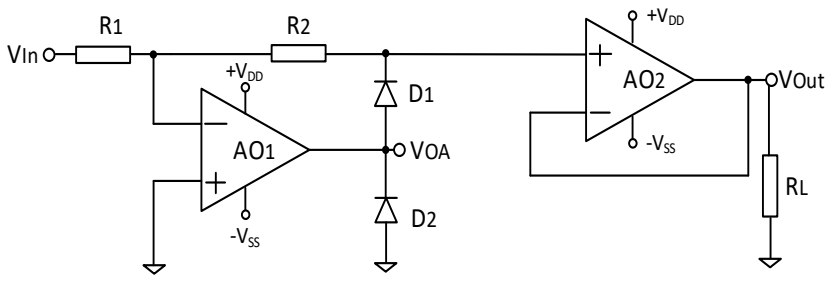
[picture p37: figure]
VIn; -VSS; +VDD; VOut; VOA

Fig.30. Tip 10 Etaj 4

Etajul 4 constă într-un redresor dublă alternanță de precizie, realizat într-o configurație cu două amplificatoare operaționale și două diode de comutație (D1, D2). Circuitul utilizează amplificatorul AO1 pentru a procesa semnalul de intrare și a extrage valoarea absolută a acestuia, în timp ce AO2 este configurat ca repetor de tensiune pentru a asigura o impedanță de ieșire scăzută pe sarcina RL. Etajul asigură un câștig liniar de 1, transformând semnalul sinusoidal de la intrare într-o succesiune de alternanțe pozitive.

### 4.2. Dimensionarea și proiectarea Etajului 4

### 4.2.1. Proiectarea Redresorului

### a. Dimensionare

Pentru dimensionarea redresorului, se va utiliza schema generală (Fig.30), iar ca strategie de dimensionare se vor utiliza notițele de curs „Circuite Neliniare”:

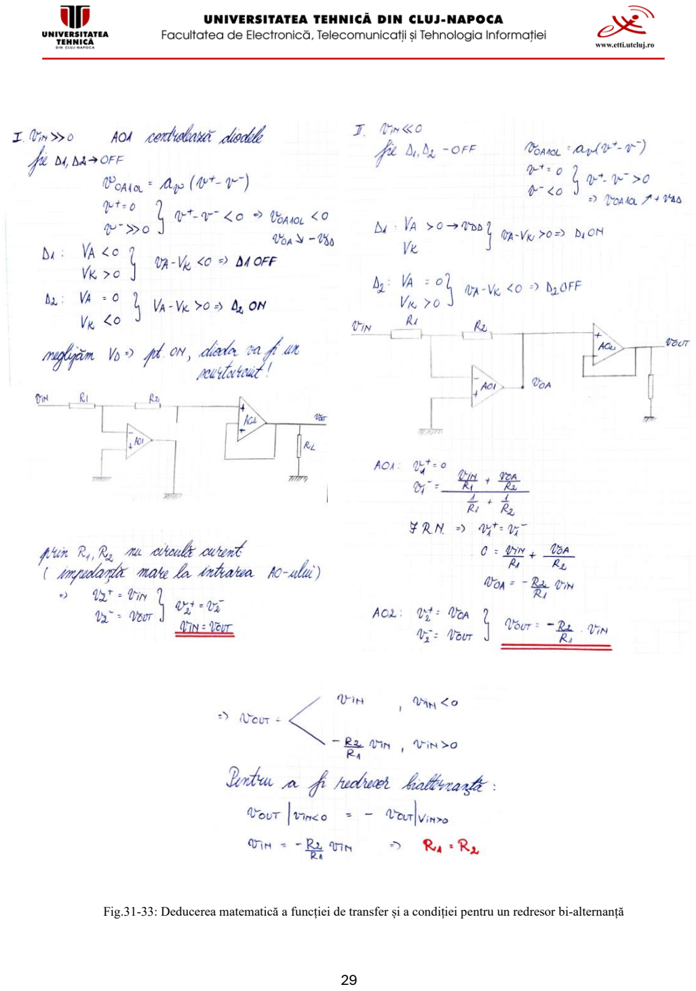
[picture p38: page 29]

Fig.31-33: Deducerea matematică a funcției de transfer și a condiției pentru un redresor bi-alternanță

Deoarece pentru a îndeplini condiția de redresor bi-alternanță R1 și R2 trebuie să fie egale, am ales R1 = R2 = 1kΩ.

### b. Proiectare

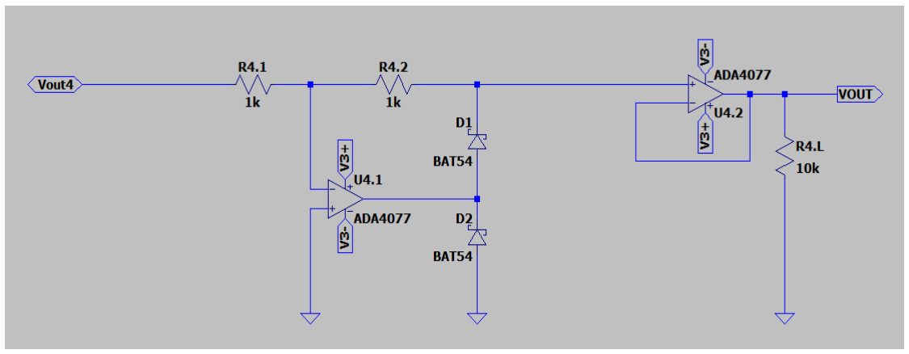
[picture p39: figure]

Fig.34. Proiectarea Etajului 4 în LTSpice

S-au utilizat diode de tip BAT54 deoarece acestea sunt diode Schottky, având o tensiune de deschidere foarte mică. Ele permit redresorului să reacționeze mult mai precis la semnale de amplitudine mică, eliminând erorile de comutare care apar mai pronunțat la alte diode.

### 4.3. Caracterizarea Etajului 3

a) DC OP

### - Punctul static de funcționare

Analiza DC OP confirmă că, la o tensiune de intrare nulă, Etajul IV menține o precizie ridicată, deoarece curentul de polarizare și tensiunile reziduale sunt minime. Valorile de ordinul microvolților identificate la ieșire se datorează tensiunii de decalaj specifice ADA4077. De asemenea, curentul rezidual al diodelor BAT54 la 0V asigură faptul că rețeaua de protecție nu introduce o eroare suplimentară semnificativă, permițând circuitului să funcționeze liniar chiar și la praguri de semnal foarte scăzute.

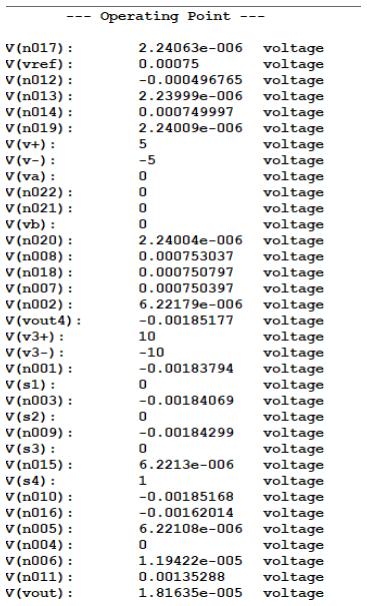
[picture p40: figure]

Fig.35. Analiza .op a Etajului 4

b) DC Sweep + Transient

### - Câștigul

Pentru analiza DC Sweep, pe intrarea circuitului am aplicat un semnal cu amplitudinea de 3.5 V (obținut la Etajul 3). După cum se observă, am realizat CSTV-ul funcției de circuit:

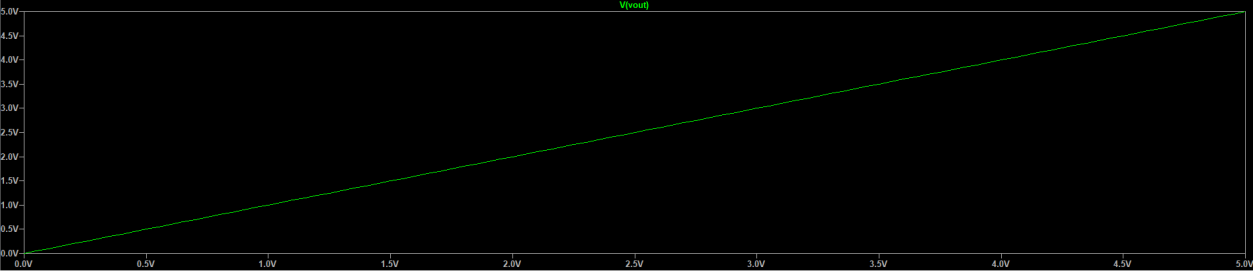
[picture p41: figure]

Fig.36. Caracteristica CSTV a redresorului pentru alternanța pozitivă

Pentru valori ale intrării mai mici de 0, tensiunea de ieșire va fi egală în modul cu cea de intrare, dar de semn opus. Pentru tensiuni mai mari ca 0, tensiunea de ieșire va fi egală cu cea de intrare, caracteristică corespunzătoare unui redresor bi-alternanță.

c) Transient

### - Funcția circuitului

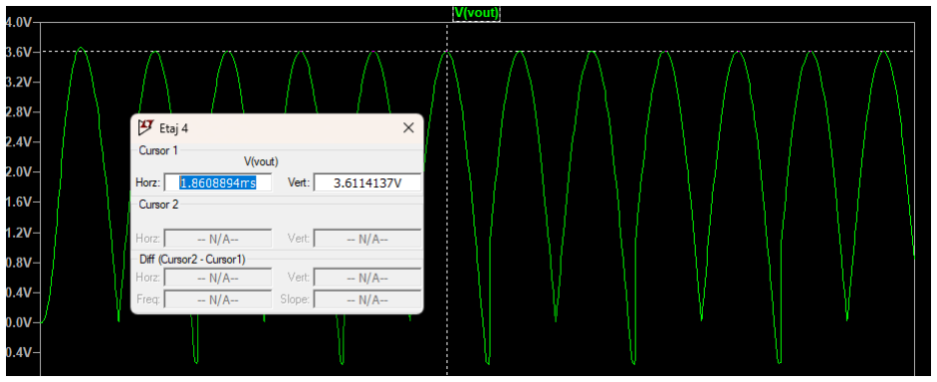
[picture p42: figure]

Fig.37. Analiza Transient a Etajului 4

Deoarece câștigul redresorului este de 1, Amplitudinea semnalului va fi 3.61V ≈ 3.5V. Spike-urile care coboară sub 0V se datorează Slew Rate-ului scăzut al ADA4077.

### - Domeniul de funcționare

Pentru a vizualiza domeniul de funcționare, am introdus o tensiune mare la intrare. Astfel, se va observa unde se saturează în realitate alimentările de 10V ale redresorului, precum și faptul că tensiunea maximă ce poate fi atinsă este mai mică decât cea a semnalului nostru de intrare (3.5V).

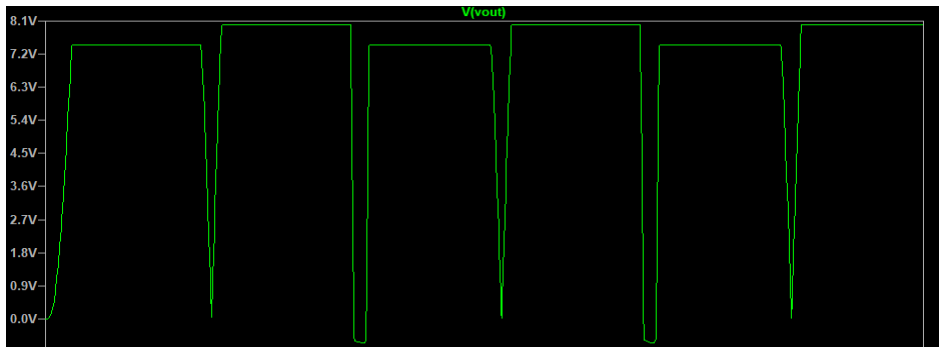
[picture p43: figure]

Fig.38. Saturarea alimentărilor

Saturarea se realizează la o valoare ridicată, de 7.2V. Pentru Vinmax = 279 mV, această limită nu va distorsiona semnalul, deoarece

279mV × 5 (Etaj I) × 1 (Etaj II) × 2.51 (AMIN, Etaj III) × 1 (Etaj IV) = 3.501V

## 3.Implementare practică

Pentru implementarea practică, s-a utilizat kittul de studiu ADALM2000 și aplicația Scopy. Deoarece nu am avut fizic modelul ADA4022, am folosit un înlocuitor, OP482.

## I. Etajul 1 (a) Implementare

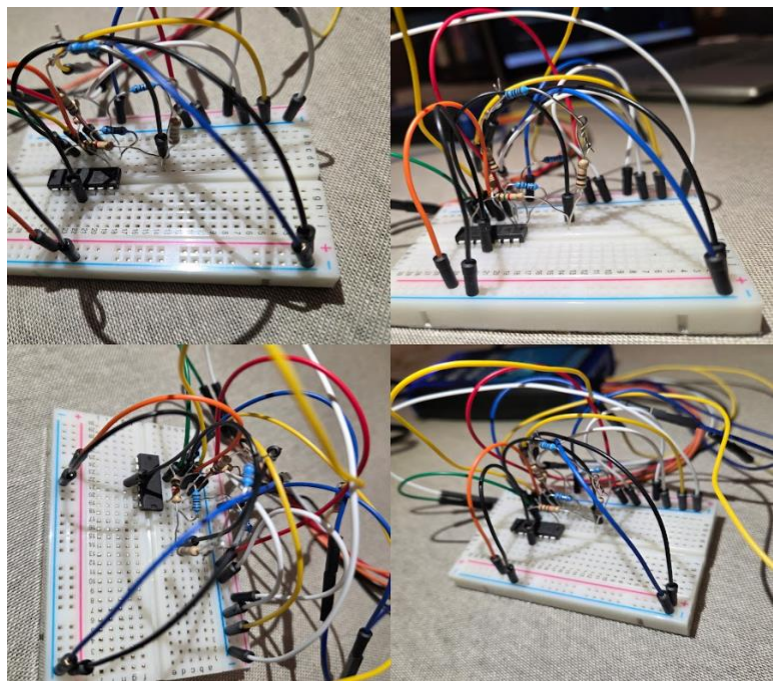
[picture p44: figure]

Fig.35. Implementarea fizică a Etajului 1

## (b) Măsurători

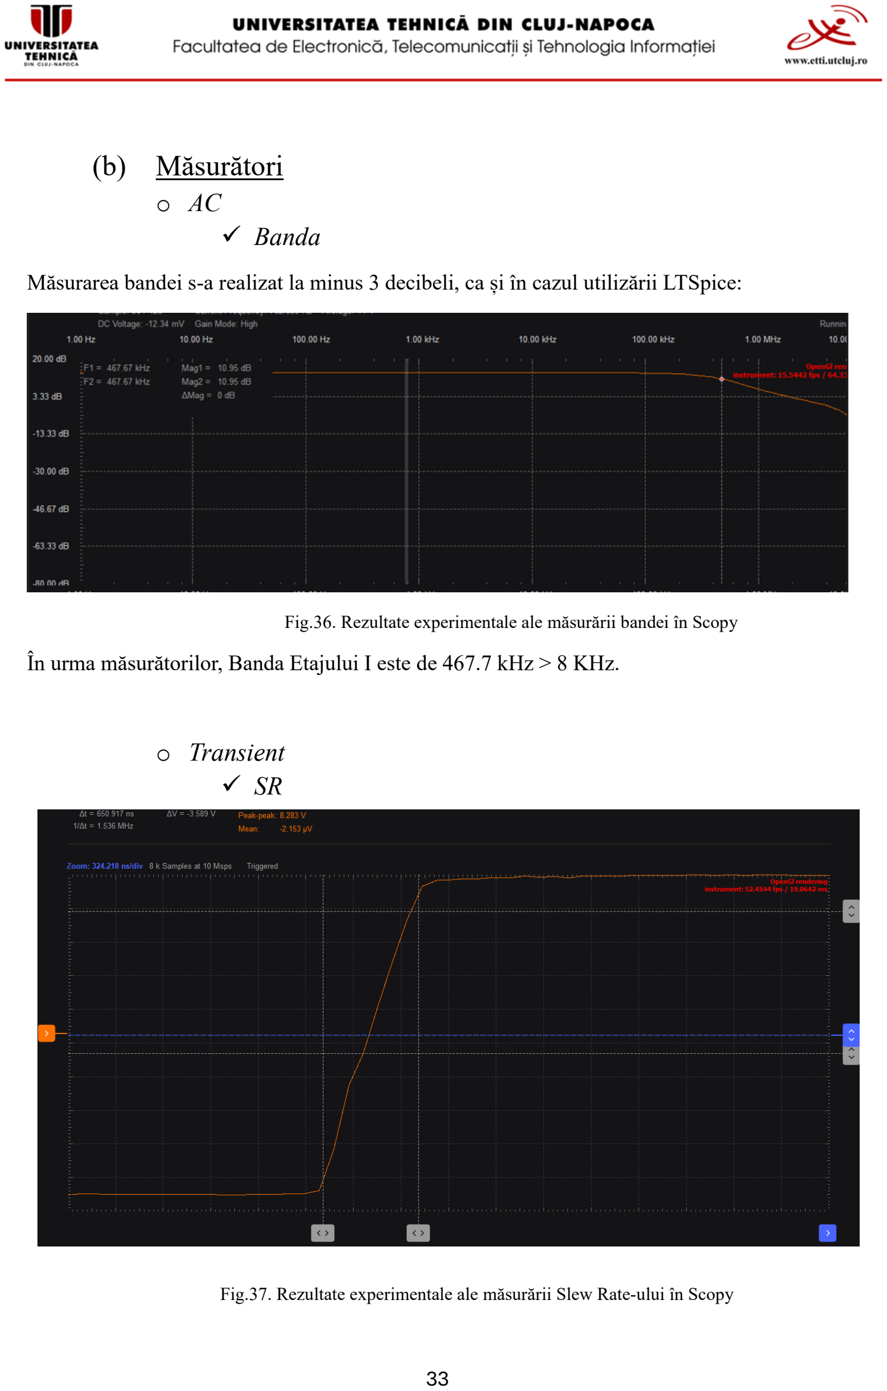
[picture p45: page 33]

- AC

### ✓ Banda

Măsurarea bandei s-a realizat la minus 3 decibeli, ca și în cazul utilizării LTSpice:

Fig.36. Rezultate experimentale ale măsurării bandei în Scopy

În urma măsurătorilor, Banda Etajului I este de 467.7 kHz > 8 KHz.

### - Transient

✓ SR

Fig.37. Rezultate experimentale ale măsurării Slew Rate-ului în Scopy

Slew Rate-ul măsurat va fi SR =

ΔVOUT
Δt

= 2.33 V/us. Acesta este mai mic decât Slew Rate-ul maxim al OP482 (9 V/us), dar mai mare decât valoarea calculată teoretic ( SR = 2πfVOUT = 0.201 V/us.).

## II. Etajul 2 (a) Implementare

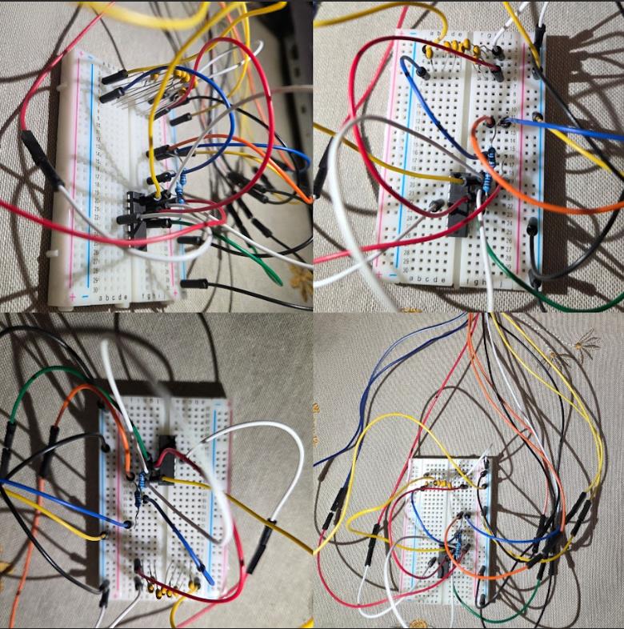
[picture p46: figure]

Fig.38. Implementarea fizică a Etajului 2

## (b) Măsurători

- AC

### ✓ Câștig

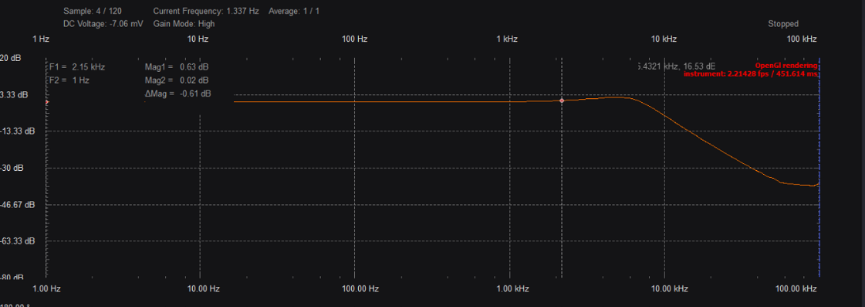
[picture p47: figure]

Fig.39. Rezultate experimentale ale măsurării Gain-ului în Scopy

După cum se observă, în banda de trecere câștigul este <1 dB. Deoarece în implementarea practică nu avem conectat și Etajul 1, care introducea un câștig propriu, câștigul filtrului este nul.

### ✓ Banda

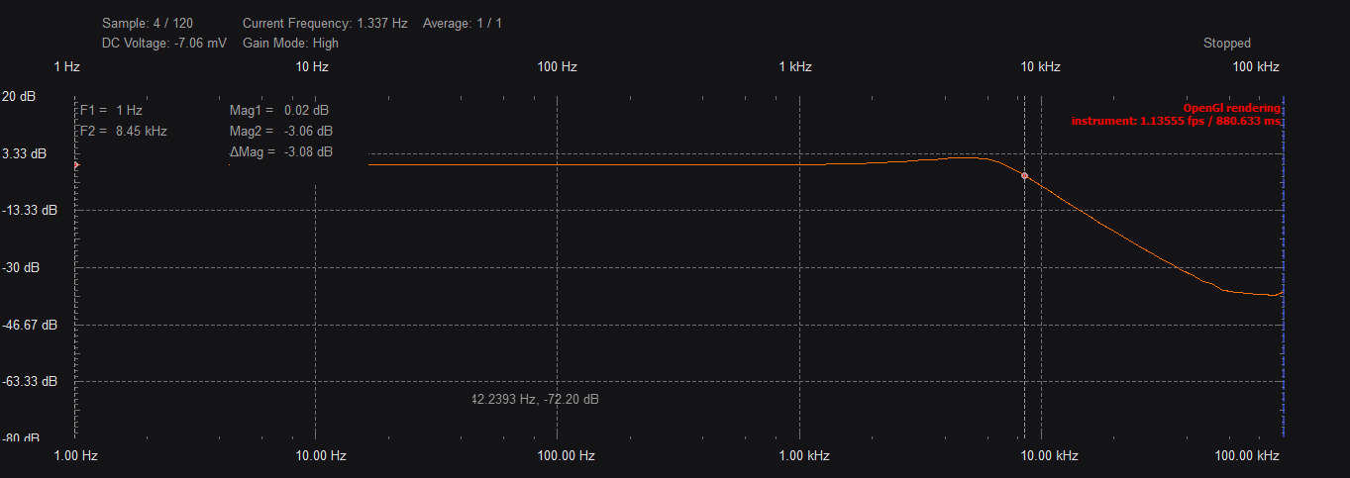
[picture p48: figure]

Fig.40. Rezultate experimentale ale măsurării benzii filtrului în Scopy

După cum se observă (cursorul 2), la -3dB frecvența este de 8.45 kHz. Acest lucru coincide cu implementarea teoretică a etajului 2.

## III. Etajul 3

### (a) Implementare

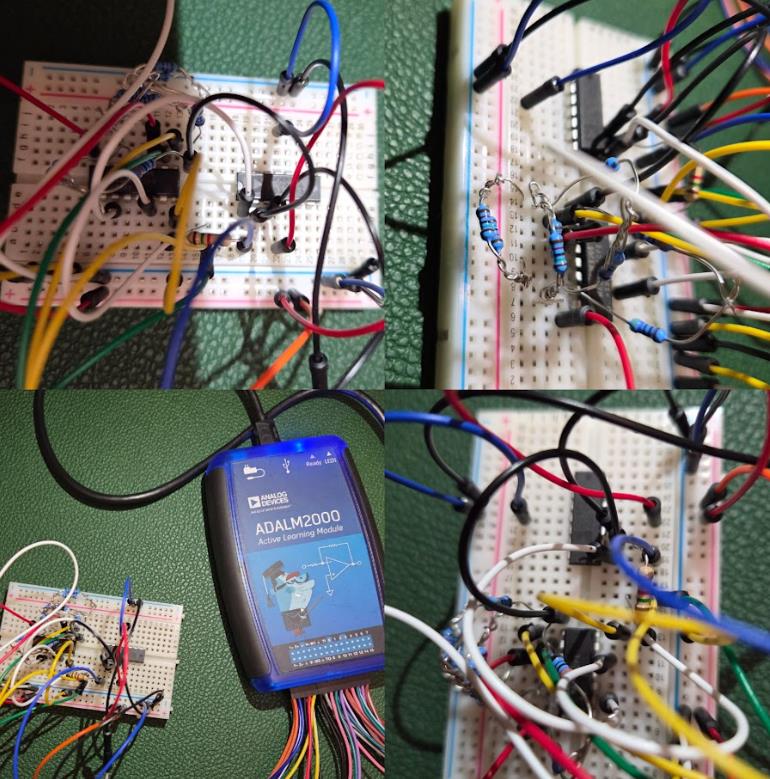
[picture p49: figure]

Fig.41. Implementarea fizică a Etajului 3

### (b) Măsurători

- AC

### ✓ Câștig

Câștigul (implicit și banda) s-a realizat pentru amplitudinea minima de intrare (14 dB, 12 dB), cât și pentru cea maximă (10 dB, 8 dB). Erorile cresc odată cu creșterea treptelor și provin din faptul că, în realitate, amplificatorul se saturează la o tensiune mai mica de 5V. Deoarece am folosit un multiplexor pentru a implementa switchurile, s-au modificat și secvențele DIO.

### 8 dB

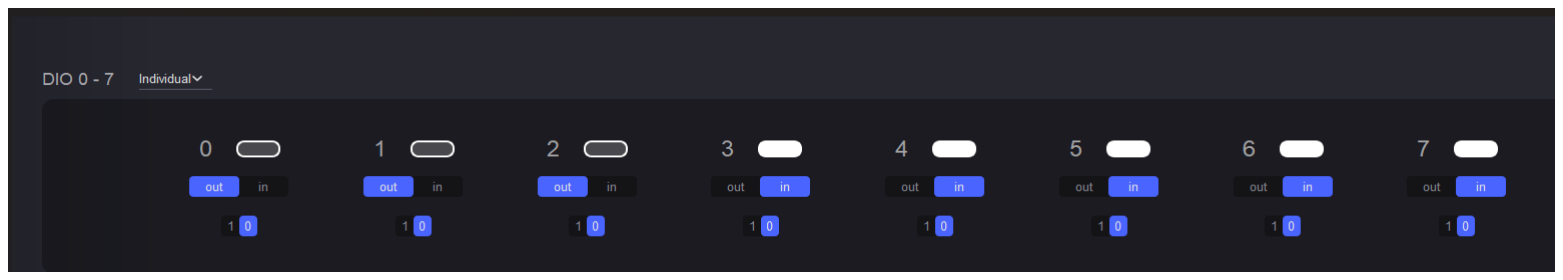
[picture p50: figure]

Fig.41. Configurația primei trepte în meniul DIO

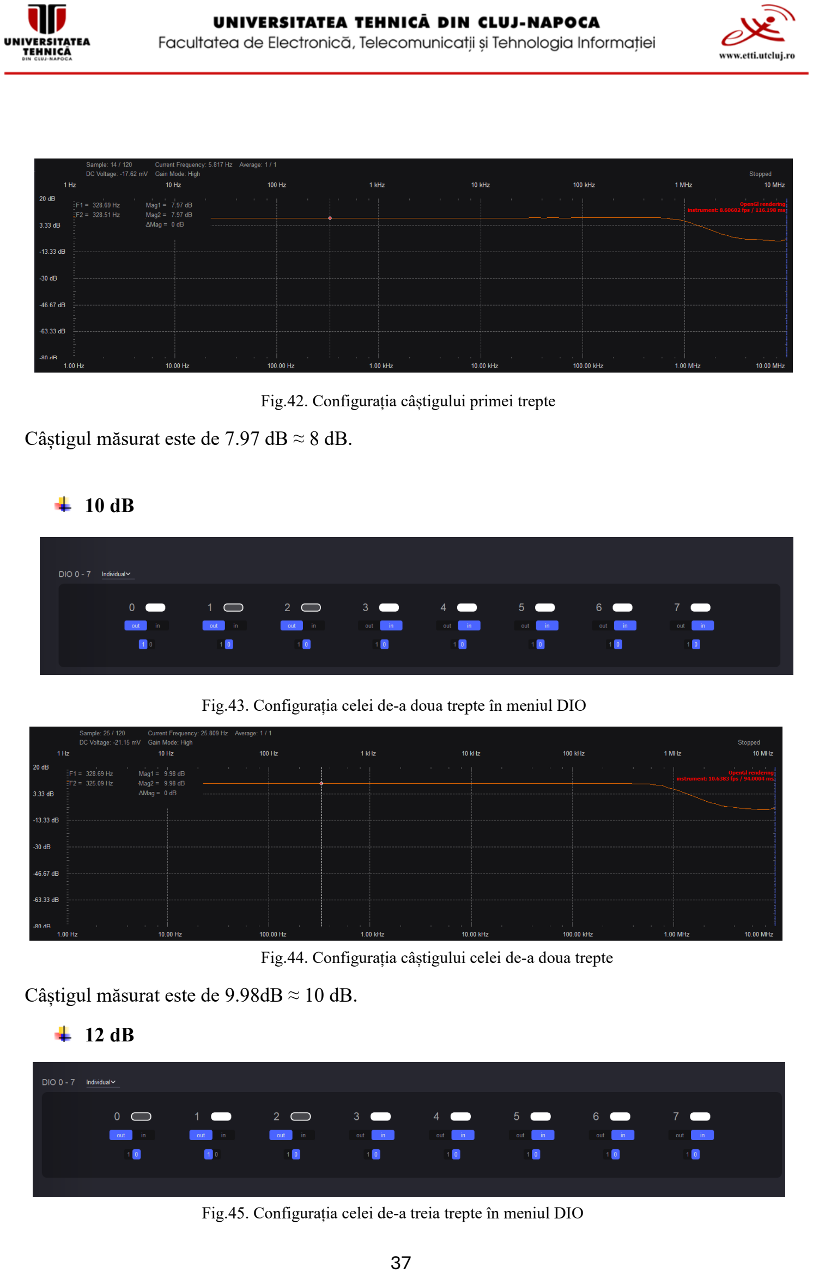
[picture p51: page 37]

Fig.42. Configurația câștigului primei trepte

Câștigul măsurat este de 7.97 dB ≈ 8 dB.

### 10 dB

Fig.43. Configurația celei de-a doua trepte în meniul DIO

Fig.44. Configurația câștigului celei de-a doua trepte

Câștigul măsurat este de 9.98dB ≈ 10 dB.

### 12 dB

Fig.45. Configurația celei de-a treia trepte în meniul DIO

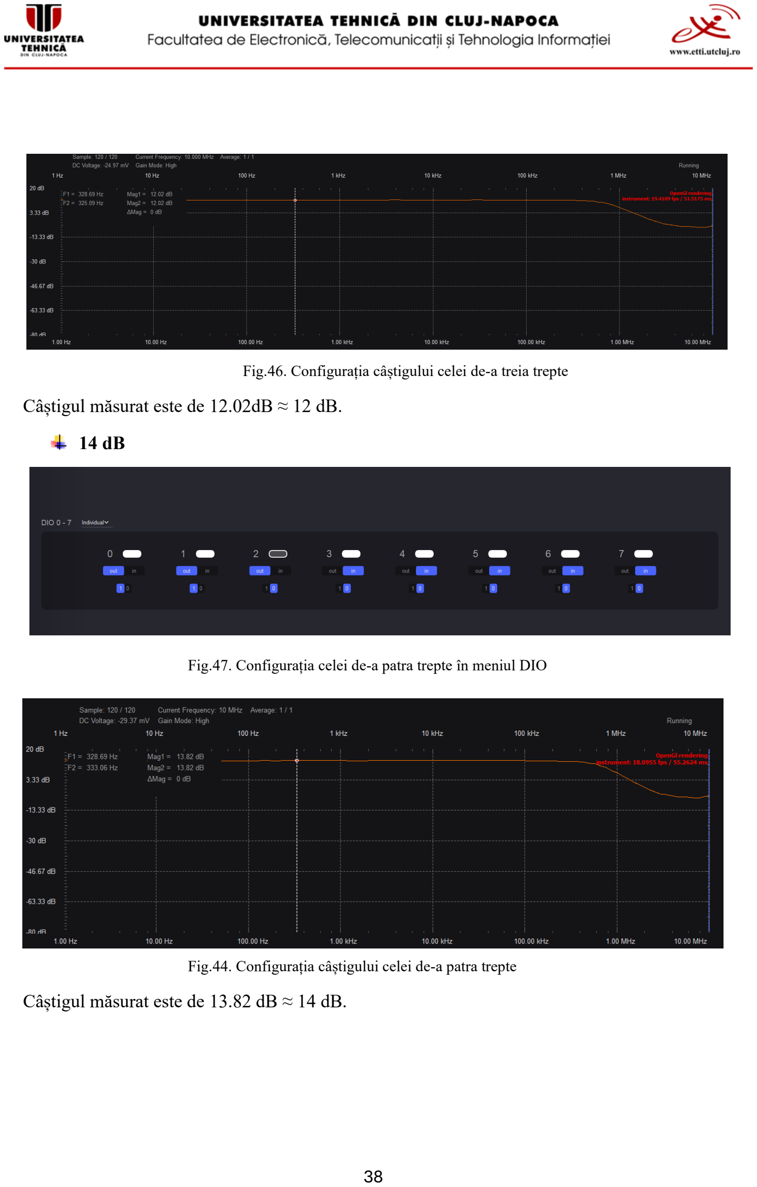
[picture p52: page 38]

Fig.46. Configurația câștigului celei de-a treia trepte

Câștigul măsurat este de 12.02dB ≈ 12 dB.

### 14 dB

Fig.47. Configurația celei de-a patra trepte în meniul DIO

Fig.44. Configurația câștigului celei de-a patra trepte

Câștigul măsurat este de 13.82 dB ≈ 14 dB.

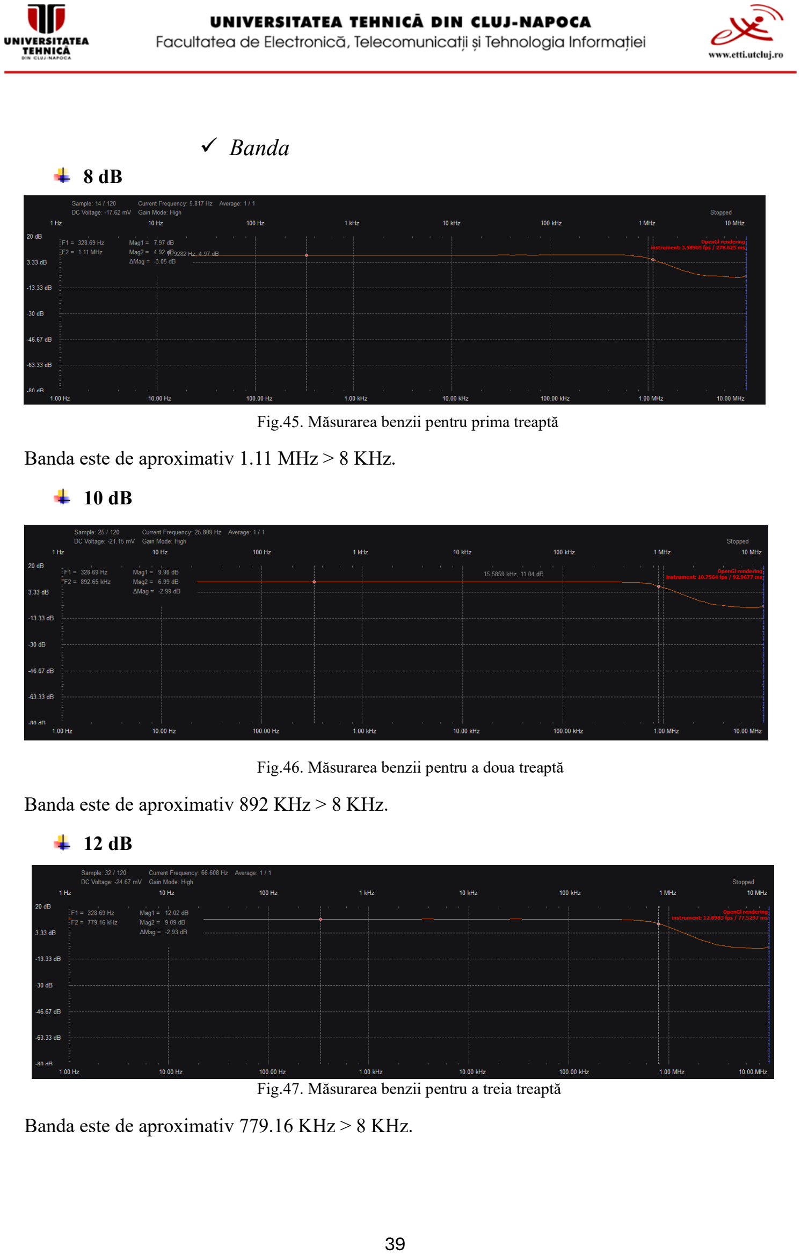
[picture p53: page 39]

### ✓ Banda

### 8 dB

Fig.45. Măsurarea benzii pentru prima treaptă

Banda este de aproximativ 1.11 MHz > 8 KHz.

### 10 dB

Fig.46. Măsurarea benzii pentru a doua treaptă

Banda este de aproximativ 892 KHz > 8 KHz.

### 12 dB

Fig.47. Măsurarea benzii pentru a treia treaptă

Banda este de aproximativ 779.16 KHz > 8 KHz.

### 14 dB

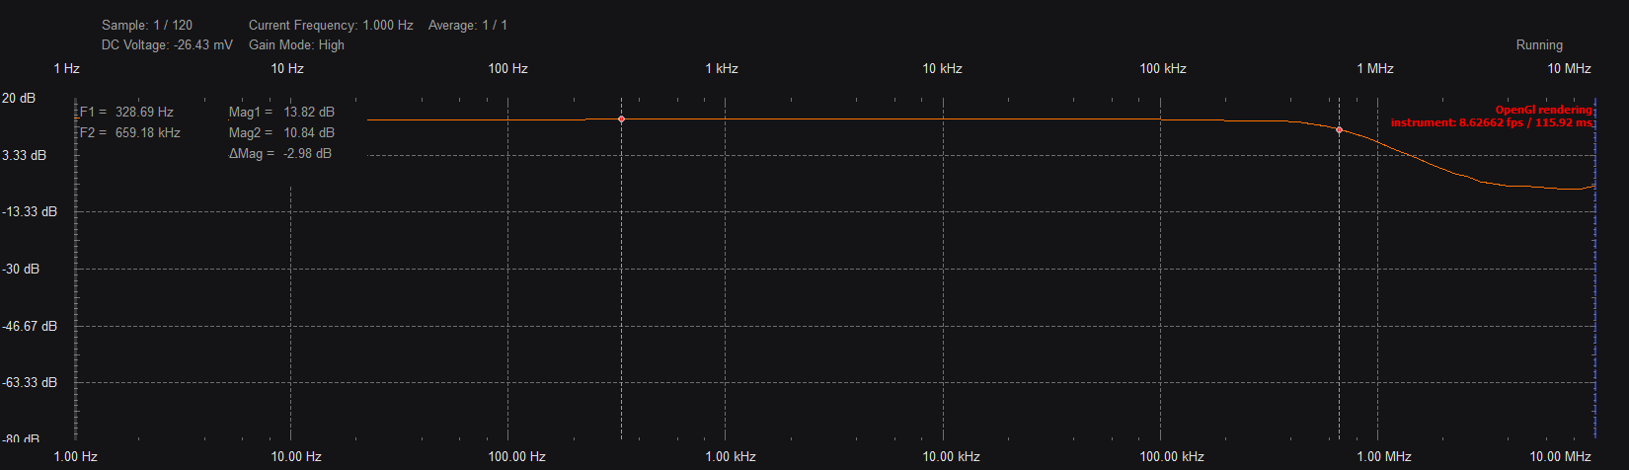
[picture p54: figure]

Fig.47. Măsurarea benzii pentru a patra treaptă

Banda este de aproximativ 669.18 KHz > 8 KHz.

## IV. Etajul 4

### (a) Implementare

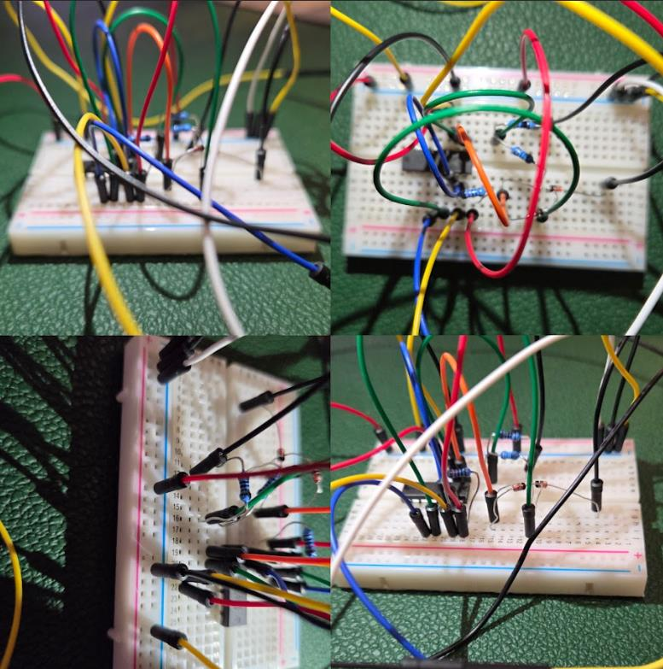
[picture p55: figure]

Fig.41. Implementarea fizică a Etajului 4

### (b) Măsurători - Transient ✓ Funcție circuit

Fiind un redresor bi-alternanță, semnalul sinusoidal de intrare trebuie să fie redresat pe ieșire:

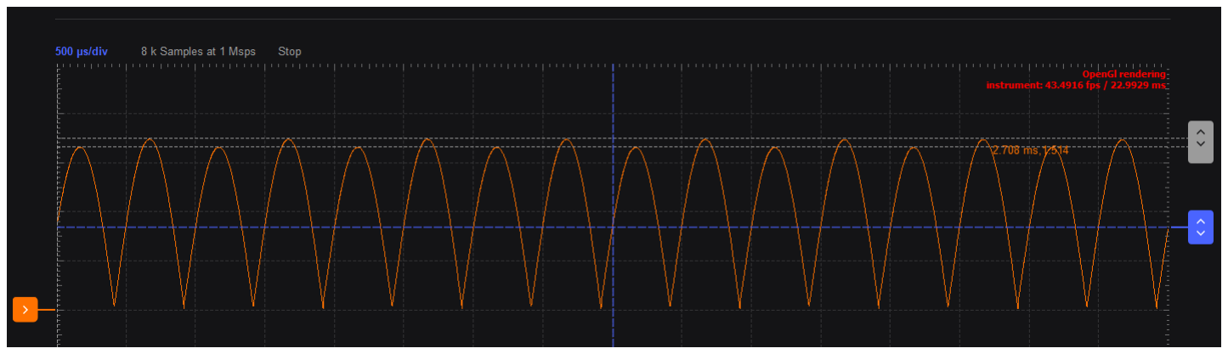
[picture p56: figure]

Fig.41. Funcționalitatea Etajului 4

Deoarece sursele de alimentare ale ADALM2000 sunt de maxim 5V, introducerea tensiunii maxime ar fi dus la saturare. Am folosit amplitudinea minimă pentru a demonstra funcționalitatea circuitului, independent de alimentarea acestuia.

## 4.Concluzii

Rezultatele obținute și cauze ale erorilor

Rezultatele obținute sunt, în mare parte, fidele tabelului de cerințe. Eventualele erori de ordinul micro- pot surveni din faptul că proiectarea circuitului s-a realizat pentru componente ideale, iar în implementare survin și neidealitățile componentelor (toleranțe, capacități parazite, curenți de polarizare, folosirea unor valori echivalente care nu sunt întocmai egale cu rezistențele calculate, zgomotul propagat la ieșire etc.)

Simulări vs. Măsurători

Parametru | Simulări | Măsurători | Specificații
Tip amplificator | ADA4077 | OP482 | ADA4077
Etaj 1 | Banda | 692.81904kHz | 467.7 KHz | >8KHz
Slew Rate | 1.186 V/us | 2.33 V/us | -
Etaj 2 | Câștig | 0 dB (13.97 dB, dacă considerăm Etajul 1 conectat) | 0 dB | 1
| Banda | 8.008 KHz | 8.45 KHz | 8 KHz
Etaj 3 | Câștig | 7.90 dB | 7.97 dB | 8 dB
| | 9.98 dB | 9.98 dB | 10 dB
| | 11.88 dB | 12.02 dB | 12 dB
| | 13.78 dB | 13.82 dB | 14 dB
| Banda | 1.67 MHz | 1.1 MHz | >8KHz
| | 1.36 MHz | 892 KHz
| | 1.064 MHz | 779.16 KHz
| | 766.69 KHz | 669.18 KHz
Etaj 4 | Funcție de circuit | Funcționează în ambele cazuri; diferă frecvențele la care circuitul încetează să redea fidel tensiunea de intrare la ieșire (SR) | | -

Bibliografie

1) Notițe de curs SCIA – prof. Conf. Dr. Ing. Marius Neag
2) Lucrări de Laborator – curs SCIA
3) https://www.ti.com/lit/an/sloa024b/sloa024b.pdf
4) https://www.electronics-tutorials.ws/diode/diode_6.html
5) https://www.ti.com/lit/an/sboa281a/sboa281a.pdf?ts=1766033970254
6) https://www.analog.com/media/en/training-seminars/design-handbooks/system-applications-guide/Section3.pdf
