Antonia-Tunsoiu/4-Stage-Amplifier/Etaj 3/8db/Screenshot 2026-01-03 225731.png

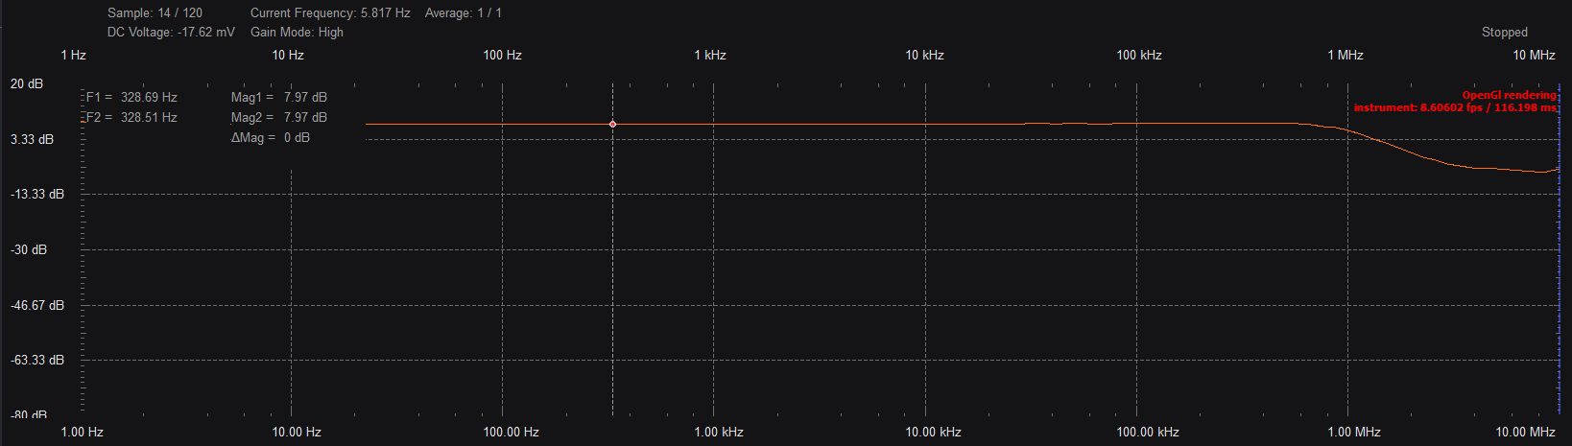
Etaj 3/8db/Screenshot 2026-01-03 225731.png
