Antonia-Tunsoiu/4-Stage-Amplifier/Etaj 3/10db/Screenshot 2026-01-03 225550.png

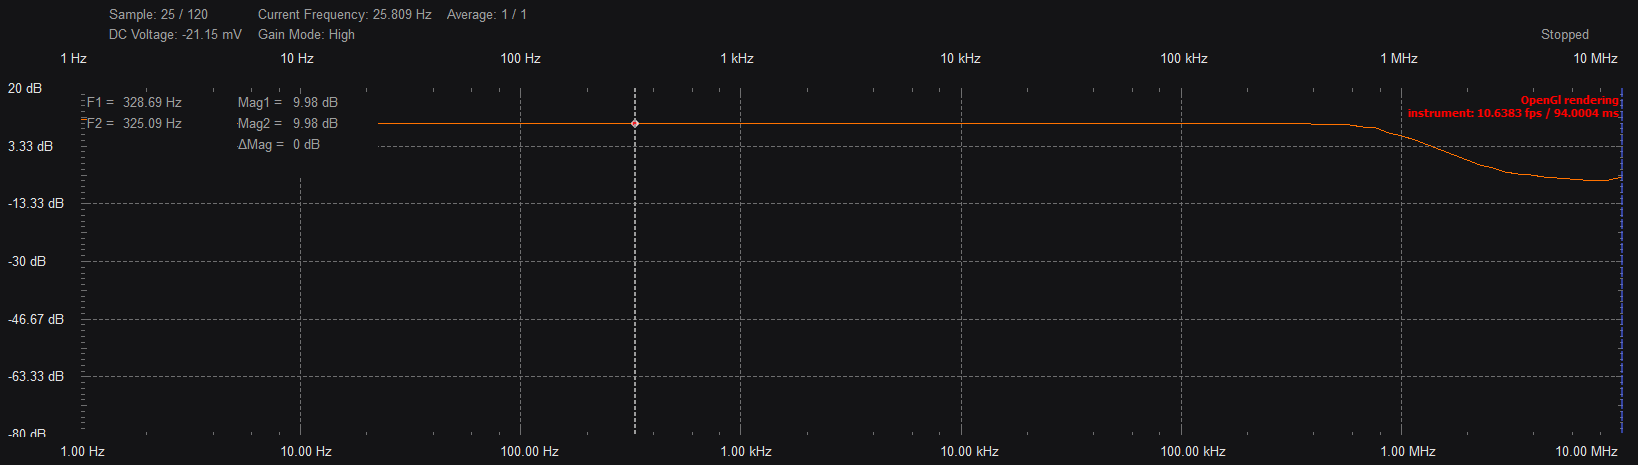
Etaj 3/10db/Screenshot 2026-01-03 225550.png
