Antonia-Tunsoiu/4-Stage-Amplifier/Etaj 3/12db/Screenshot 2026-01-03 225307.png

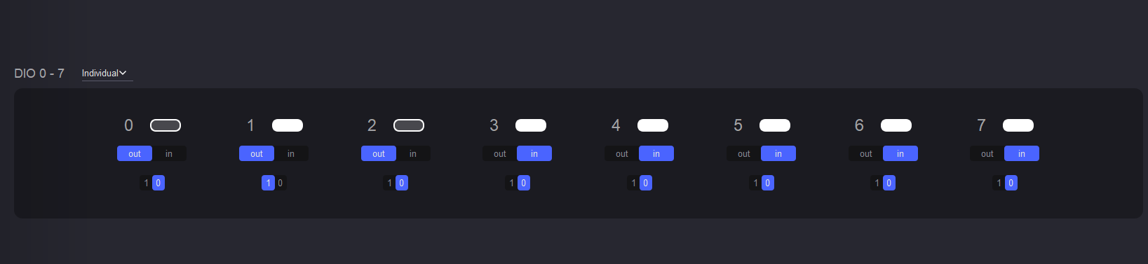
Etaj 3/12db/Screenshot 2026-01-03 225307.png
