Antonia-Tunsoiu/4-Stage-Amplifier/Etaj 3/14db/Screenshot 2026-01-03 224943.png

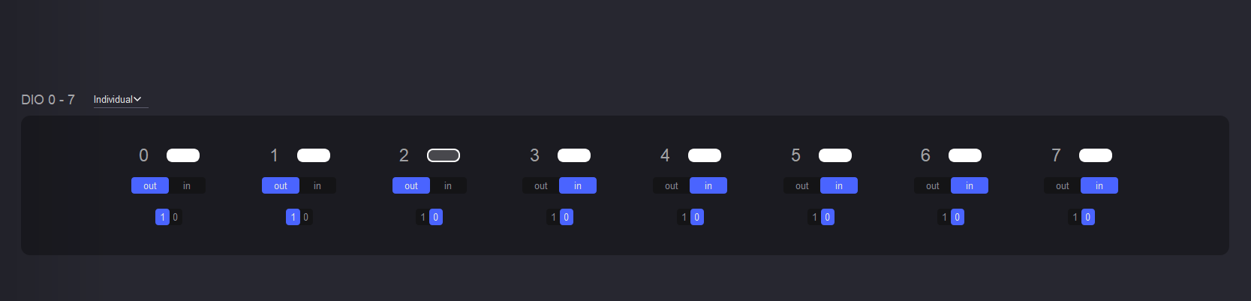
Etaj 3/14db/Screenshot 2026-01-03 224943.png
