Antonia-Tunsoiu/4-Stage-Amplifier/Etaj 3/14db/Screenshot 2026-01-03 224957.png

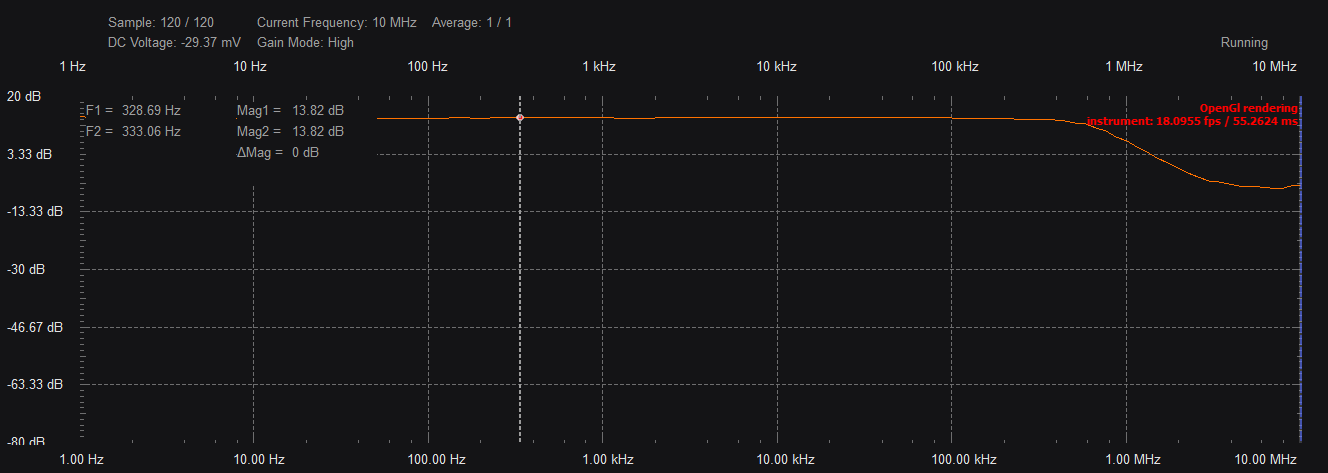
Etaj 3/14db/Screenshot 2026-01-03 224957.png
