Antonia-Tunsoiu/4-Stage-Amplifier/Etaj 1/Etaj1.asc

E1: e; 0.5
E2: e; 0.5
R1: res; 1.5k
R2: res; 1k
R3: res; 1k
R4: res; 1.5k
RG1: res; 1k
RG2: res; 100
RG3: res; 100
U1: ADA4077
U2: ADA4077
V1: voltage; 5
V2: voltage; -5
V3: voltage; 0.75m
Vicm: voltage; ""; AC 0
Vid: voltage; SINE(0 279m 8k); AC 1
Named nets: 0, V+, V-, VA, VB, VOUT1, Vref
;op
;ac dec 100 1 1Meg
.tran 10m
;four 1k V(vout1)
