Antonia-Tunsoiu/4-Stage-Amplifier/Etaj 1/Etaj1CMRR.asc

E1: e; 0.5
E2: e; 0.5
R1: res; 1.5k
R2: res; 1k
R3: res; 1k
R4: res; 1.5k
RG1: res; 1k
RG2: res; 100
RG3: res; 100
U1: ADA4077
U2: ADA4077
V1: voltage; 5; AC 0
V2: voltage; -5
V3: voltage; 0.75m
Vicm1: voltage; ""; AC {u(prb)}
Vid1: voltage; 0; AC {u(-prb)}
Named nets: 0, V+, V-, VA, VB, VOUT1, Vref
;op
.ac dec 100 10m 1Meg
.step param prb list -1 1
.func AD() V(VOUT1)@1
.func APS() V(VOUT1)@2
.func CMRR() AD()/APS()
;tran 10m
;four 1k V(vout1)
