Antonia-Tunsoiu/4-Stage-Amplifier/Etaj 2/Etaj 2.asc

C1: cap; 47n
C2: cap; 4.7n
C3: cap; 4.7n
C4: cap; 4.7n
C5: cap; 2.2n
E1: e; 0.5
E2: e; 0.5
R3: res; 1.5k
R4: res; 1k
R5: res; 1k
R6: res; 1.5k
R7: res; 1k
R8: res; 1k
RG1: res; 1k
RG2: res; 100
RG3: res; 100
U2: ADA4077
U3: ADA4077
U4: ADA4077
V4: voltage; 5
V5: voltage; -5
V6: voltage; 0.75m
Vicm1: voltage; ""; AC 0
Vid1: voltage; 279m; AC 1
Named nets: 0, V+, V-, VA, VB, Vref, VOUT2, VOUT1
;ac dec 100 1 1Meg
.op
;tran 10m
