Antonia-Tunsoiu/4-Stage-Amplifier/Etaj 3/Etaj 3.asc

C8: cap; 47n
C9: cap; 10n
C10: cap; 4.7n
C11: cap; 2.2n
C12: cap; 4.7n
C13: cap; 4.7n
C14: cap; 2.2n
E1: e; 0.5
E2: e; 0.5
R1: res; 1.5k
R2: res; 1k
R3: res; 1k
R4: res; 1.5k
R7: res; 1k
R8: res; 1k
RF1A: res; 3.3k
RF1B: res; 470
RF2A: res; 4.7k
RF2B: res; 47
RF3A: res; 15k
RF3B: res; 10k
RF4A: res; 15k
RF4B: res; 15k
RFG: res; 1.5k
RG1: res; 1k
RG2: res; 100
RG3: res; 100
S1: sw
S2: sw
S3: sw
S4: sw
U1: ADA4077
U2: ADA4077
U3: ADA4077
U4: ADA4077
V1: voltage; 5
V2: voltage; -5
V3: voltage; 0.75m
V4: voltage; SINE(0 1.395 8k); AC 1
VE31: voltage; 10
VE32: voltage; -10
Vicm1: voltage; ""; AC 0
Vid1: voltage; 279m; AC 1
VS1: voltage; 1
VS2: voltage; 0
VS3: voltage; 0
VS4: voltage; 0
Named nets: 0, V+, V-, VA, VB, Vref, VOUT2, VOUT3, V3+, V3-, S1, S2, S3, S4
.ac dec 100 1 10Meg
.op
;tran 10m
.FOUR 1khz 10 V(VOUT3)
.model SW SW(Ron=1m Roff=1Meg Vt=0.5 Vh=0))
