Antonia-Tunsoiu/4-Stage-Amplifier/Etaj 4/Etaj 4.asc

C1: cap; 47n
C2: cap; 10n
C3: cap; 4.7n
C4: cap; 2.2n
C5: cap; 4.7n
C6: cap; 4.7n
C7: cap; 2.2n
D1: schottky; BAT54
D2: schottky; BAT54
E1: e; 0.5
E2: e; 0.5
R1: res; 1.5k
R2: res; 1k
R3: res; 1k
R4.1: res; 1k
R4.2: res; 1k
R4.L: res; 10k
R4: res; 1.5k
R5: res; 1k
R6: res; 1k
RF1: res; 15k
RF2: res; 4.7k
RF3: res; 3.3k
RF4: res; 470
RF5: res; 47
RF6: res; 10k
RF7: res; 15k
RF8: res; 15k
RFG1: res; 1.5k
RG1: res; 1k
RG2: res; 100
RG3: res; 100
S1: sw
S2: sw
S3: sw
S4: sw
U1: ADA4077
U2: ADA4077
U3: ADA4077
U4.1: ADA4077
U4.2: ADA4077
U4: ADA4077
V1: voltage; 5
V2: voltage; -5
V3: voltage; 0.75m
VE1: voltage; 10
VE2: voltage; -10
Vicm1: voltage; ""; AC 0
Vid1: voltage; SINE(0 279m 1k); AC 1
VS1: voltage; 0
VS2: voltage; 0
VS3: voltage; 0
VS4: voltage; 1
Named nets: 0, V+, V-, VA, VB, Vref, V3+, V3-, S1, S2, S3, S4, VOUT, Vout4
.model SW SW(Ron=1m Roff=1Meg Vt=0.5 Vh=0))
.tran 10m
lt1208
